iorodeo/expresso_device_hardware/README.txt

Hardware design files (i.e., PCB, enclosure, and mounting rack) for IO 
Rodeo's Expresso device.  An Nx5-channel level detector used for 
measuring the amount of fluid contained in a 1mm diameter capillary tube.
