iorodeo/expresso_device_hardware/fly_holder/svg/top.pdf

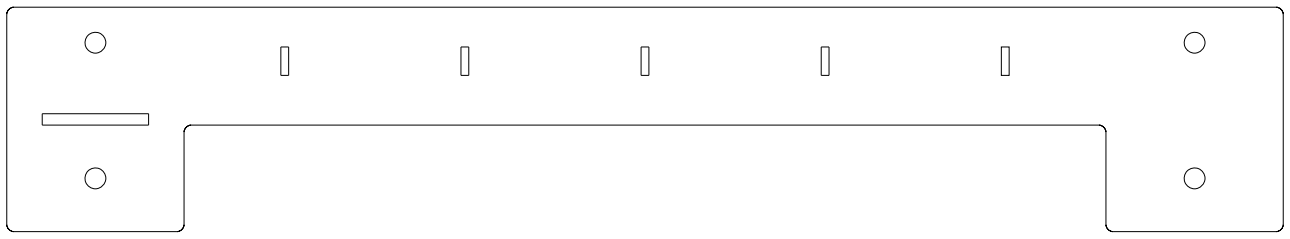
[picture p1: figure]
