iorodeo/expresso_device_hardware/fly_holder/svg/base.pdf

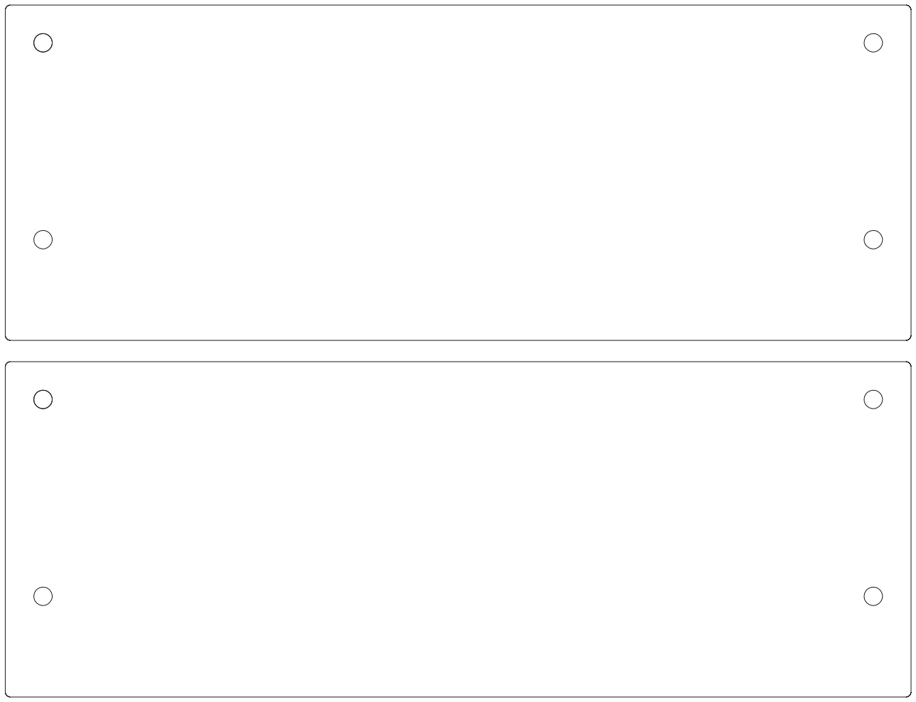
[picture p2: figure]
