iorodeo/expresso_device_hardware/enclosure/pdf/v1.2/1.5mm_white_facr.pdf

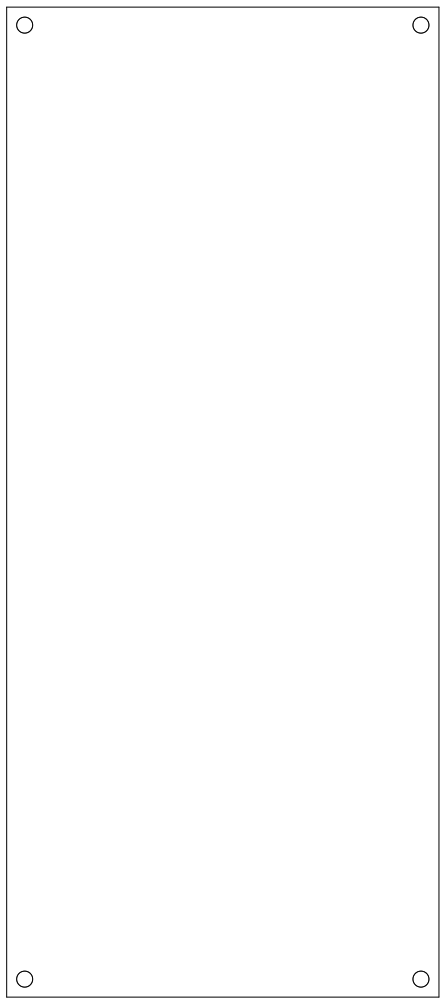
[picture p3: figure]
