iorodeo/expresso_device_hardware/rack/expresso_rack_BOM.txt

Capillary Array Rack - Bill of Materials

Stock parts
===========

Description                                                                                             Vendor          Part#       Price      Qty     Purchased
------------------------------------------------------------------------------------------------------------------------------------------------------------------
* 1/4-20 x 5/16 button socket cap 18-8 stainless steel 50-pack                                          McMaster-Carr   92949A533   7.87       1       no

* 4 hole inside corner bracket                                                                          McMaster-Carr   47065T223   3.98       4       no

* 4-40 threaded insert 10-pack                                                                          McMaster-Carr   99362A200   7.49       1       no

* 4-40 x 3/8 plastic-head thumb screw (black) 25-pack                                                   McMaster-Carr   91185A220   8.65       1       no

* cables-to-go 7 Port USB 2.0 Hub                                                                       Amazon          B000IZDN60  26.68      1       no

Custom parts
============

Description                                                                                             Vendor                                   Qty
----------------------------------------------------------------------------------------------------------------------------------------------------------------------
* capillary rack walls, custom laser cut acrylic part, design files in subdirectory                     IO Rodeo Inc.                             2

* capillary rack foot, custom laser cut acrylic part, design files in subdirectory                      IO Rodeo Inc.                             1

* capillary rack vial shelf, custom laser cut acrylic part, design files in subdirectory                IO Rodeo Inc.                             1

* capillary rack vial cart (floor), custom laser cut acrylic part, design files in subdirectory         IO Rodeo Inc.                             5

* capillary rack vial cart (floor), custom laser cut acrylic part, design files in subdirectory         IO Rodeo Inc.                             5

* capillary rack vial cart (back wall), custom laser cut acrylic part, design files in subdirectory     IO Rodeo Inc.                             5

* capillary rack vial cart (front wall), custom laser cut acrylic part, design files in subdirectory    IO Rodeo Inc.                             5
----------------------------------------------------------------------------------------------------
Desc.                               Qty.    Part No.                    Company             Price($)
----------------------------------------------------------------------------------------------------
1/8" Matte Black Acrylic 8"x12"     1       25094-01                    Inventables         8.00
1/16" Brushed Alum. on Black 4"x12" 1       25257-03                    Incentables         4.36
1/16" Black Acrylic 12"x12"         1       24112-07                    Inventables         4.03
1/16" White (.31T) Acrylic 4"x12"   1       24129-04                    Inventables         1.99
1/16" Clear Acrylic 6"x4"           1       8560K178                    McMaster-Carr       0.84
Aluminum Fem. Hex Standoffs 3/4"    4       91780A113                   McMaster-Carr       2.84
Aluminum M/F. Hex Standoffs 3/16"   4       93505A513                   McMaster-Carr       2.68
3/16" 2-56 Black Ox. Screws         44*     91249A046                   McMaster-Carr       2.14
1/4" 2-56 Black Ox. Screws          4       91249A050                   McMaster-Carr       0.15
1/8" x 1/4" Compressible Spring     5       LW025020125S                Lee Spring          12.0
3/16" 4-40 Black Ox. Sock. Screws   10      91251A105                   McMaster-Carr       0.96

NOTES:
*20 guides, 8 standoffs, 10 sensor PCB, 4 diffuser, 2 LED PCB
