iorodeo/expresso_device_hardware/pcb/led/expresso_led_BOM.txt

----------------------------------------------------------------------------------------------------
Desc.                               Qty.    Part No.                    Company             Price($)
----------------------------------------------------------------------------------------------------
LED RED CLEAR 0805 SMD              75      160-1176-1-ND               Digi-Key            15.74                                                           
RES 120 OHM .2W 5% 0603 SMD         5       660-SG73P1JTTD121J          Mouser              0.70
CONN TERM BLOCK 2 POS WTB           1       478-6169-1-ND               Digi-Key            1.10
JUMPER WIRE - 0.1", 2-PIN, 12"      .5      PRT-10372                   Sparkfun            0.98
