iorodeo/expresso_device_hardware/pcb/accessories_BOM.txt

----------------------------------------------------------------------------------------------------
Desc.                               Qty.    Part No.                    Company             Price($)
----------------------------------------------------------------------------------------------------
TRANS WALL 12VDC 1.0A               1       T1061-P5P-ND                Digi-Key            13.30
RiteAV USB A to Mini-B 1 ft.        1       B001S0I1Z2                  Amazon              4.49
