iorodeo/expresso_device_hardware/fly_holder/assembly/assembly.fcstd

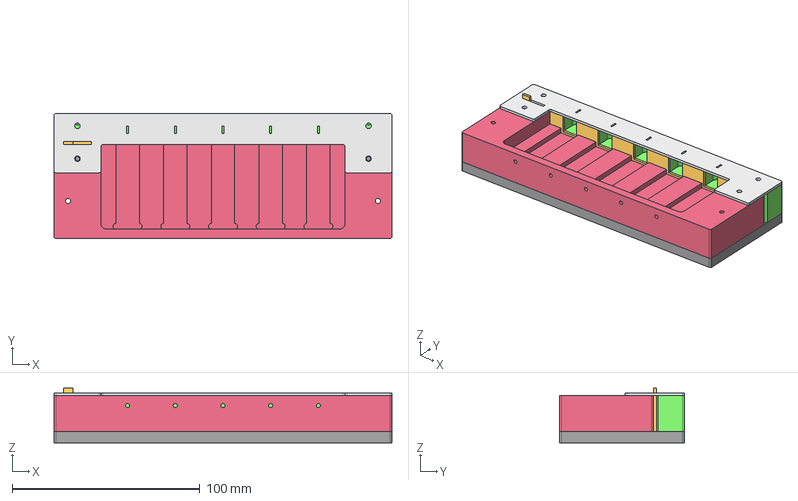
[picture p4: CAD file, 2013-05-25]
fly_holder/assembly/assembly.fcstd
180.0 x 66.6 x 29.1 mm
base
cuvette_block
feeder_block
door
top
