iorodeo/expresso_device_hardware/fly_holder/assembly/assembly_exploded.fcstd

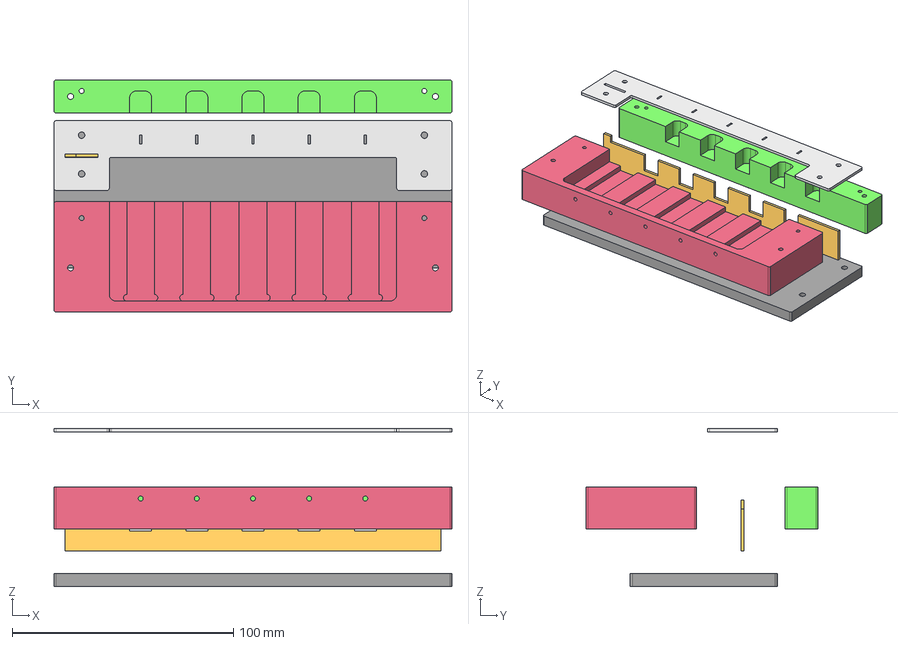
[picture p5: CAD file, 2013-05-25]
fly_holder/assembly/assembly_exploded.fcstd
180.0 x 105.0 x 71.5 mm
base
cuvette_block
feeder_block
door
top
