iorodeo/expresso_device_hardware/enclosure/dxf/back2.dxf

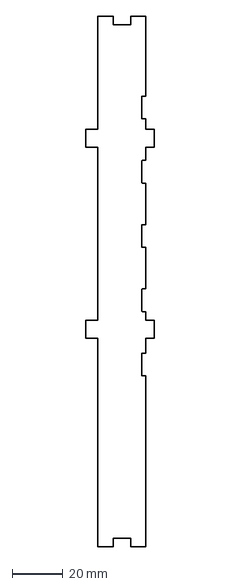
[picture p6: CAD file, 2013-01-23]
enclosure/dxf/back2.dxf
27.2 x 209.9 mm
