iorodeo/expresso_device_hardware/fly_holder/step/feeder_block.step

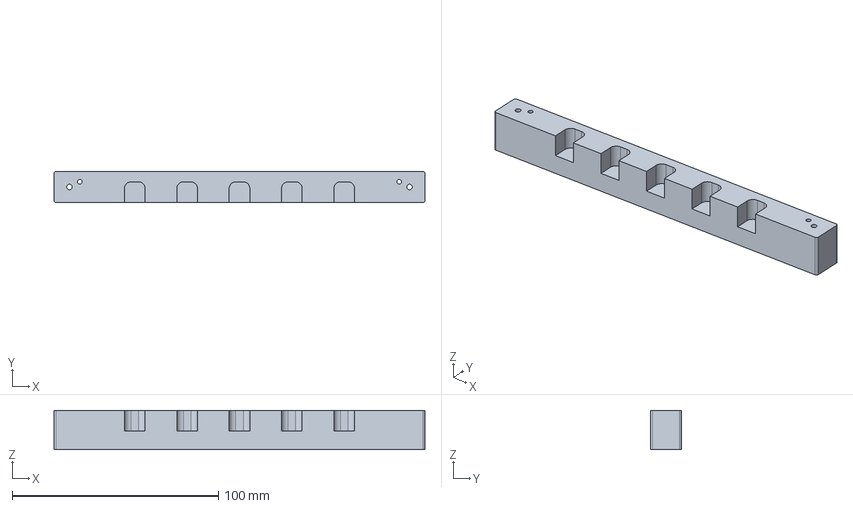
[picture p7: CAD file, 2013-05-25]
fly_holder/step/feeder_block.step
180.0 x 15.0 x 19.0 mm
