iorodeo/expresso_device_hardware/fly_holder/top.fcstd

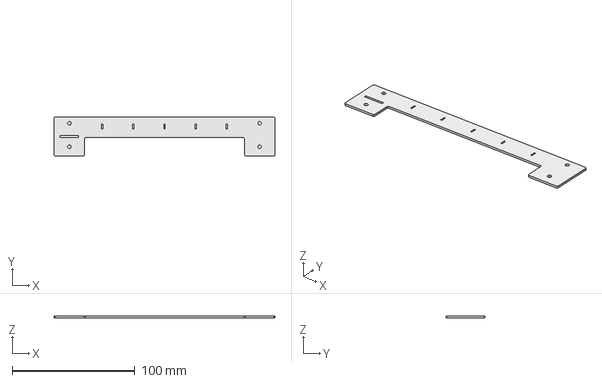
[picture p8: CAD file, 2013-06-08]
fly_holder/top.fcstd
180.0 x 31.6 x 1.50 mm
