iorodeo/expresso_device_hardware/rack/dxf/left_holder.dxf

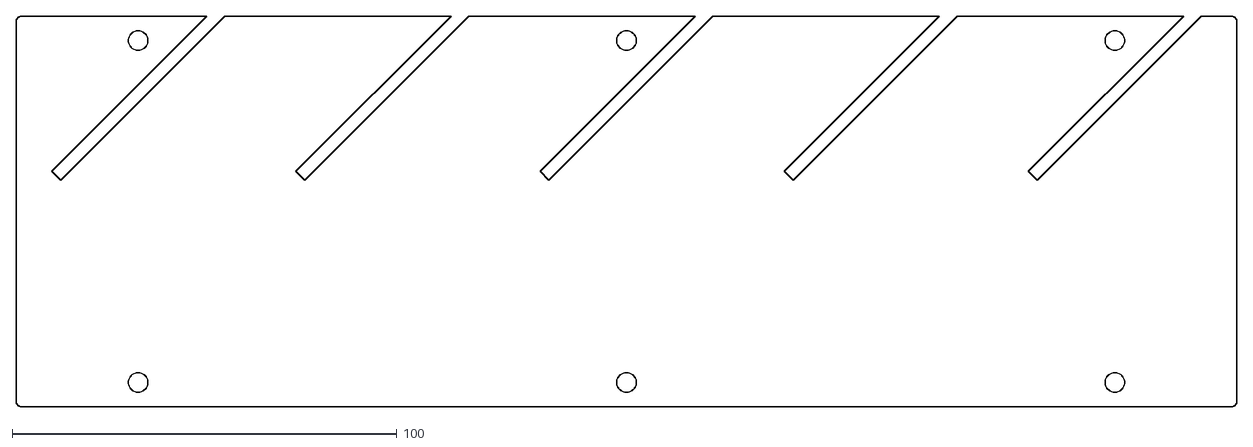
[picture p9: CAD file, 2013-03-14]
rack/dxf/left_holder.dxf
317.5 x 101.6
