iorodeo/expresso_device_hardware/enclosure/dxf/front2.dxf

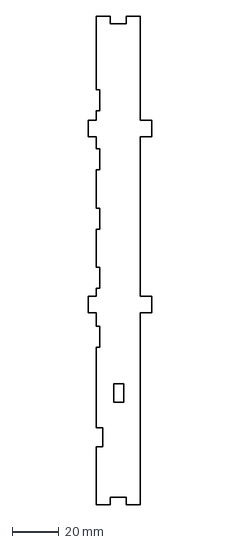
[picture p10: CAD file, 2013-01-23]
enclosure/dxf/front2.dxf
27.2 x 209.9 mm
