iorodeo/expresso_device_hardware/fly_holder/assembly/door.step

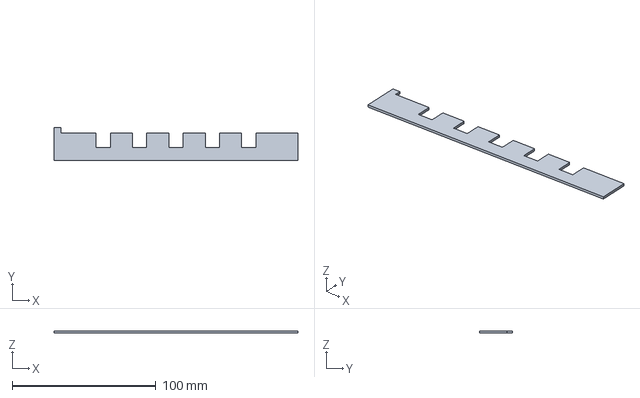
[picture p11: CAD file, 2013-05-25]
fly_holder/assembly/door.step
170.0 x 23.1 x 1.50 mm
