iorodeo/expresso_device_hardware/fly_holder/base.fcstd

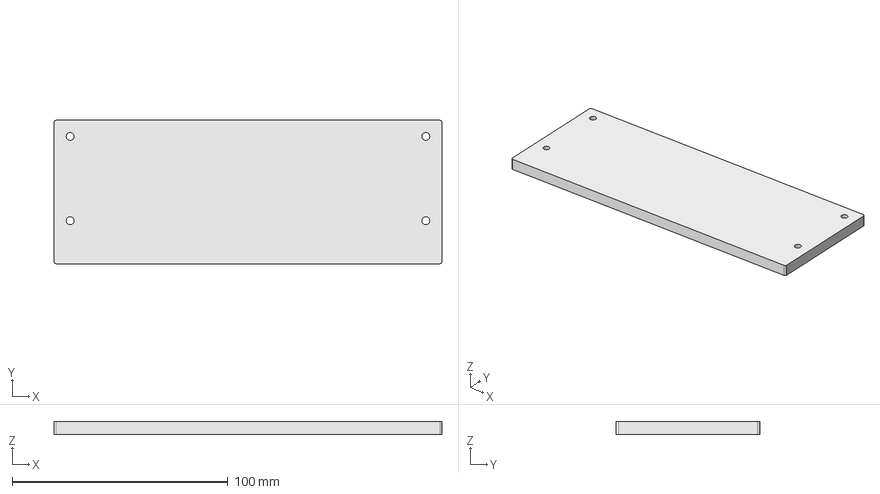
[picture p12: CAD file, 2013-05-25]
fly_holder/base.fcstd
180.0 x 66.6 x 6.00 mm
