iorodeo/expresso_device_hardware/fly_holder/step/cuvette_block.step

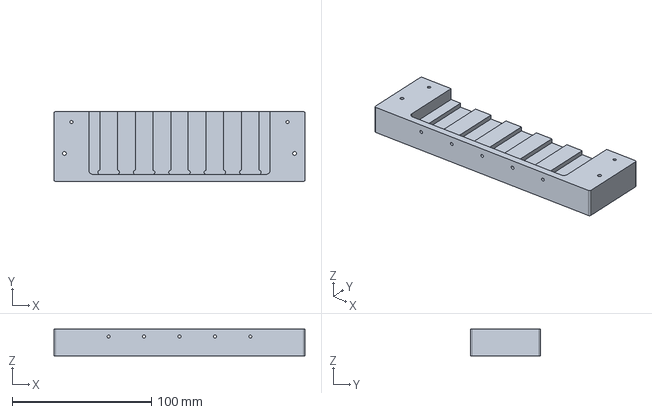
[picture p13: CAD file, 2013-05-25]
fly_holder/step/cuvette_block.step
180.0 x 50.0 x 19.0 mm
