iorodeo/expresso_device_hardware/rack/dxf/floor.dxf

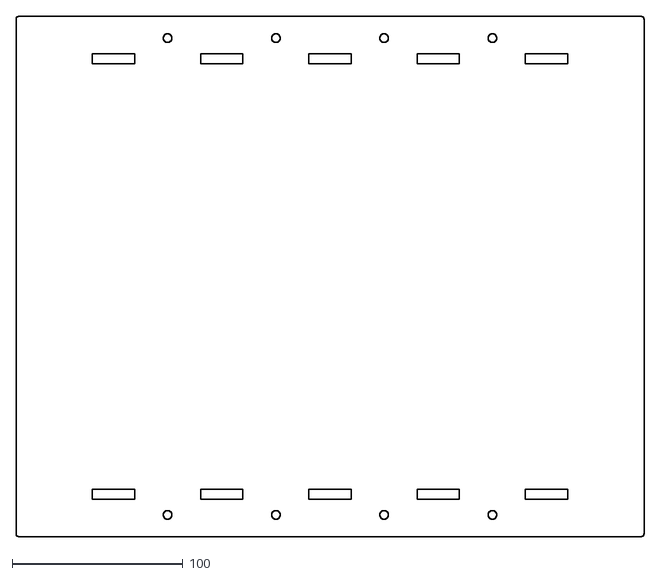
[picture p14: CAD file, 2013-03-14]
rack/dxf/floor.dxf
368.3 x 305.0
