iorodeo/expresso_device_hardware/rack/dxf/left_wall.dxf

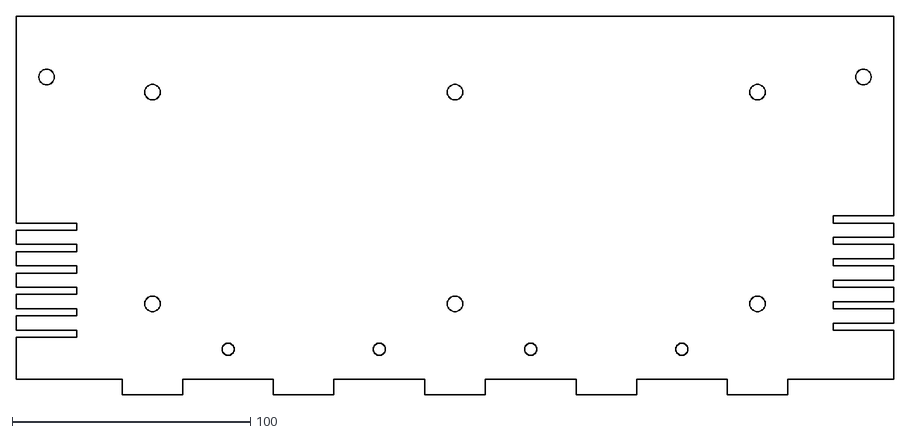
[picture p15: CAD file, 2013-03-14]
rack/dxf/left_wall.dxf
368.3 x 158.7
