iorodeo/expresso_device_hardware/enclosure/dxf/bottom.dxf

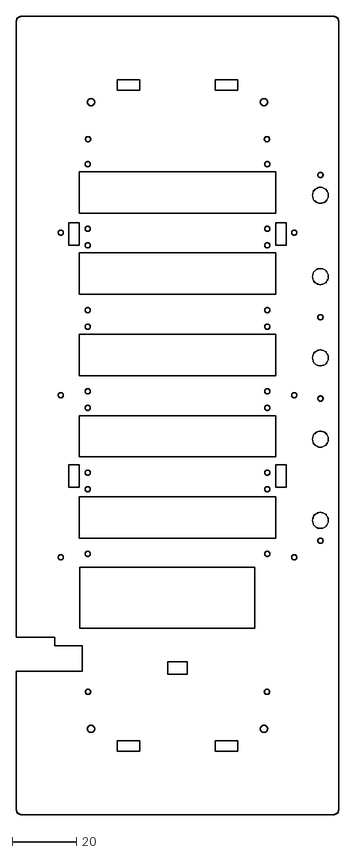
[picture p16: CAD file, 2013-01-22]
enclosure/dxf/bottom.dxf
100.7 x 249.4
