iorodeo/expresso_device_hardware/enclosure/dxf/guide_side_neg_A.dxf

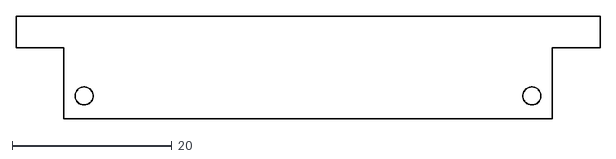
[picture p17: CAD file, 2013-01-22]
enclosure/dxf/guide_side_neg_A.dxf
73.2 x 12.9
