iorodeo/expresso_device_hardware/enclosure/dxf/top.dxf

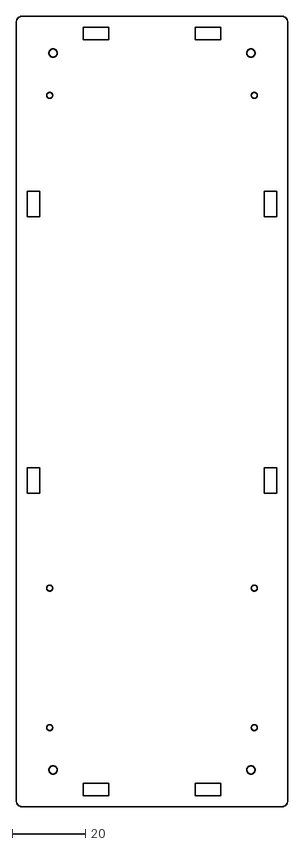
[picture p18: CAD file, 2013-01-22]
enclosure/dxf/top.dxf
74.1 x 215.9
