iorodeo/expresso_device_hardware/fly_holder/assembly/cuvette_block.step

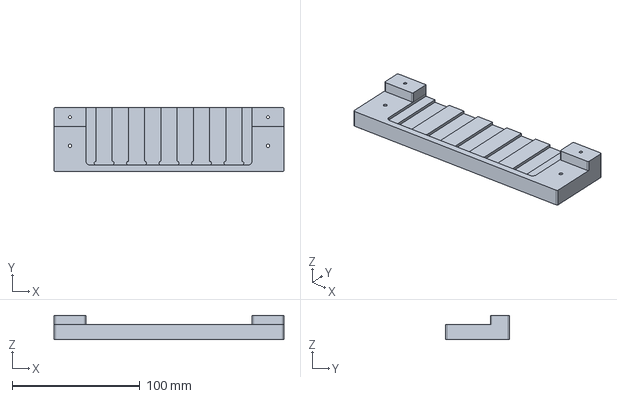
[picture p19: CAD file, 2013-05-09]
fly_holder/assembly/cuvette_block.step
180.0 x 50.0 x 19.0 mm
