iorodeo/expresso_device_hardware/rack/dxf/shelf_bar.dxf

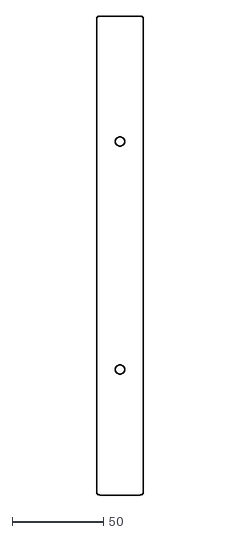
[picture p20: CAD file, 2013-03-14]
rack/dxf/shelf_bar.dxf
25.4 x 261.8
