iorodeo/expresso_device_hardware/enclosure/dxf/back.dxf

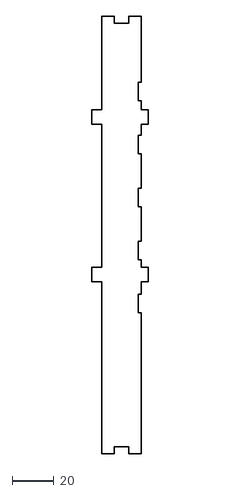
[picture p21: CAD file, 2013-01-22]
enclosure/dxf/back.dxf
27.2 x 209.9
