iorodeo/expresso_device_hardware/fly_holder/assembly/feeder_block.step

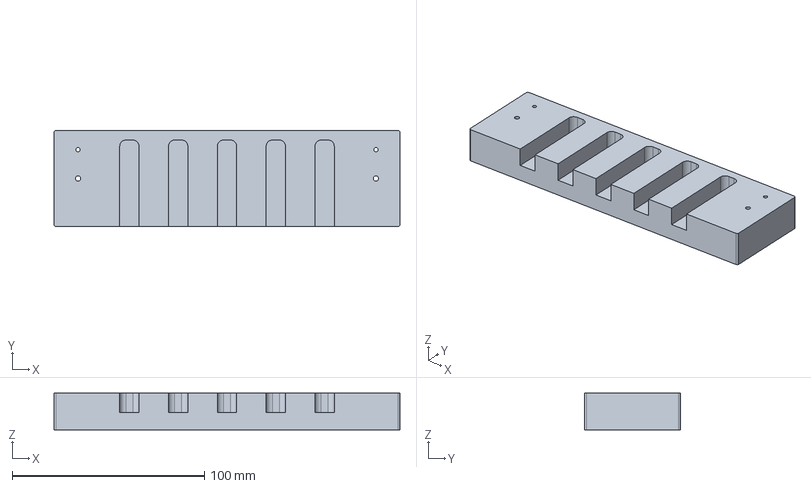
[picture p22: CAD file, 2013-05-09]
fly_holder/assembly/feeder_block.step
180.0 x 50.0 x 19.0 mm
