iorodeo/expresso_device_hardware/rack/dxf/shelf.dxf

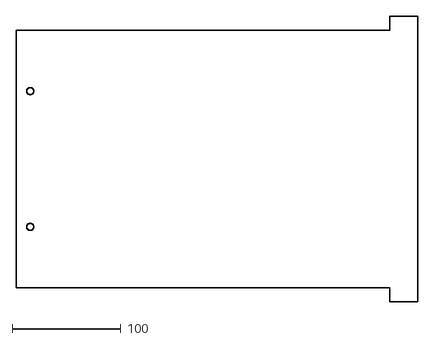
[picture p23: CAD file, 2013-03-14]
rack/dxf/shelf.dxf
368.3 x 261.8
