iorodeo/expresso_device_hardware/enclosure/dxf/guide_side_pos_A.dxf

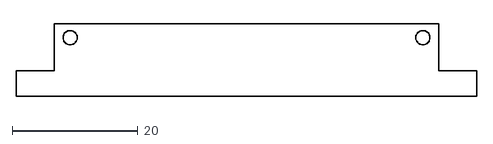
[picture p24: CAD file, 2013-01-22]
enclosure/dxf/guide_side_pos_A.dxf
73.2 x 11.5
