iorodeo/expresso_device_hardware/enclosure/dxf/right_wall2.dxf

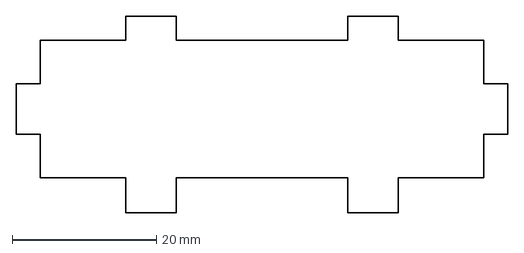
[picture p25: CAD file, 2012-10-20]
enclosure/dxf/right_wall2.dxf
68.1 x 27.2 mm
