iorodeo/expresso_device_hardware/enclosure/dxf/left_wall2.dxf

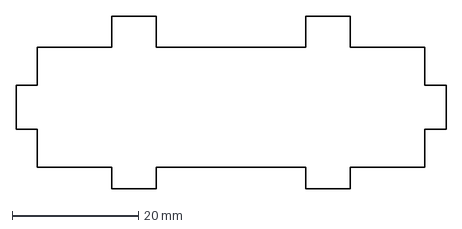
[picture p26: CAD file, 2012-10-20]
enclosure/dxf/left_wall2.dxf
68.1 x 27.2 mm
