iorodeo/expresso_device_hardware/enclosure/dxf/right_wall.dxf

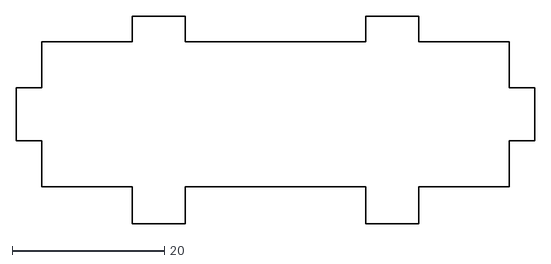
[picture p27: CAD file, 2012-10-19]
enclosure/dxf/right_wall.dxf
68.1 x 27.2
