iorodeo/expresso_device_hardware/enclosure/dxf/left_wall.dxf

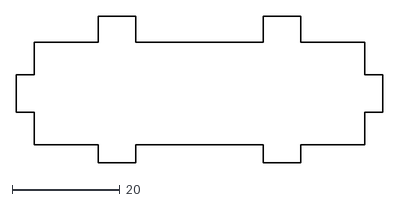
[picture p28: CAD file, 2012-10-19]
enclosure/dxf/left_wall.dxf
68.1 x 27.2
