iorodeo/expresso_device_hardware/enclosure/dxf/ref_cube.dxf

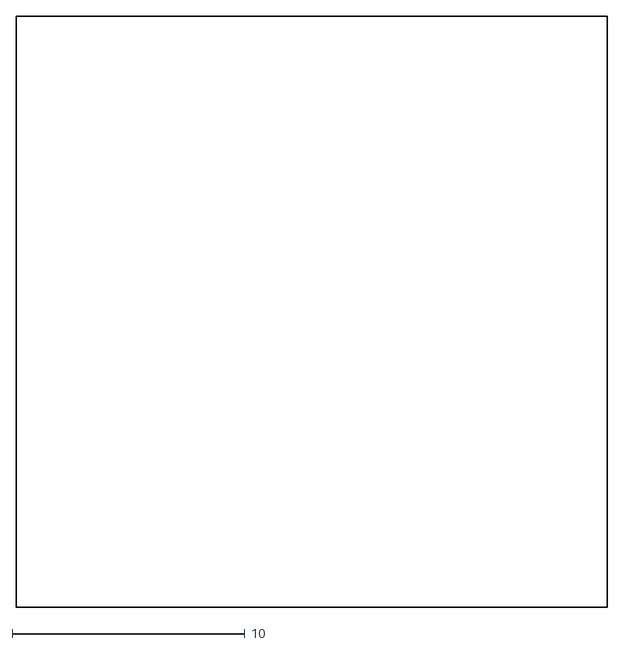
[picture p29: CAD file, 2012-10-18]
enclosure/dxf/ref_cube.dxf
25.4 x 25.4
