iorodeo/expresso_device_hardware/enclosure/dxf/guide_top.dxf

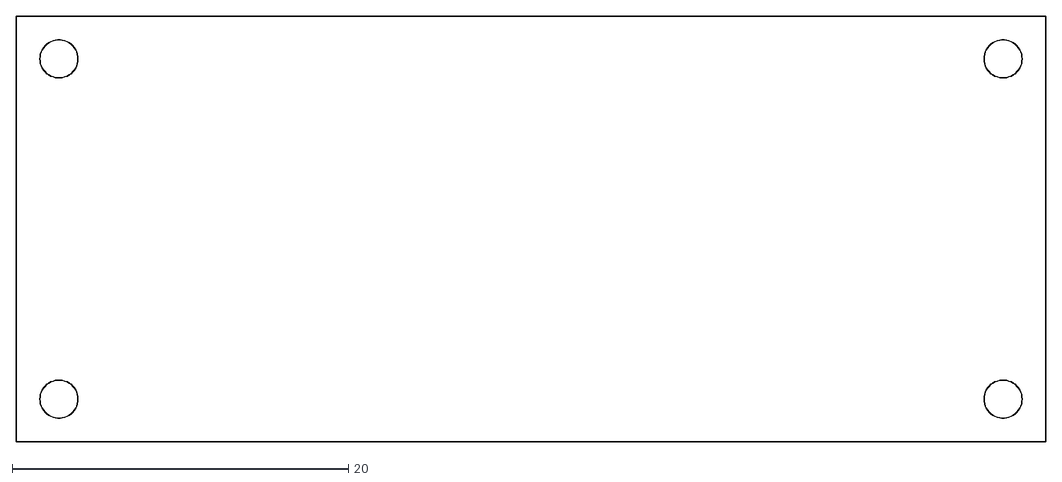
[picture p30: CAD file, 2012-10-18]
enclosure/dxf/guide_top.dxf
61.2 x 25.3
