iorodeo/expresso_device_hardware/enclosure/dxf/plunger_strip.dxf

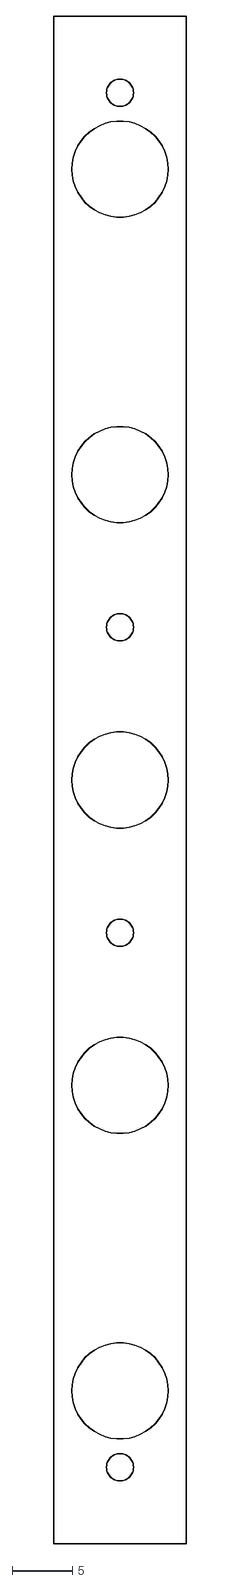
[picture p31: CAD file, 2012-10-18]
enclosure/dxf/plunger_strip.dxf
11.0 x 127.0
