iorodeo/expresso_device_hardware/enclosure/dxf/diffuser.dxf

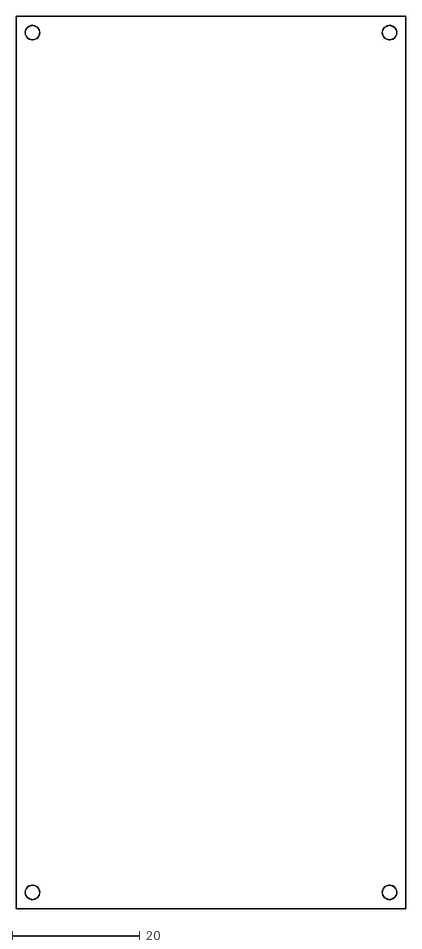
[picture p32: CAD file, 2012-10-18]
enclosure/dxf/diffuser.dxf
61.0 x 139.7
