iorodeo/expresso_device_hardware/enclosure/scad/bottom.scad

//====================================================================//
//========================= scad/bottom.scad =========================//
//                                                                    //
// Autogenerated using py2scad. Hand editing this file is not         //
// advisable as all modifications will be lost when the program which //
// generated this file is re-run.                                     //
//====================================================================//

$fn = 50;
projection(cut=true) {
    difference() {
        difference() {
            difference() {
                difference() {
                    difference() {
                        difference() {
                            difference() {
                                difference() {
                                    difference() {
                                        difference() {
                                            difference() {
                                                difference() {
                                                    difference() {
                                                        difference() {
                                                            difference() {
                                                                difference() {
                                                                    difference() {
                                                                        difference() {
                                                                            difference() {
                                                                                difference() {
                                                                                    difference() {
                                                                                        difference() {
                                                                                            difference() {
                                                                                                difference() {
                                                                                                    difference() {
                                                                                                        difference() {
                                                                                                            difference() {
                                                                                                                difference() {
                                                                                                                    difference() {
                                                                                                                        difference() {
                                                                                                                            difference() {
                                                                                                                                difference() {
                                                                                                                                    difference() {
                                                                                                                                        difference() {
                                                                                                                                            difference() {
                                                                                                                                                difference() {
                                                                                                                                                    difference() {
                                                                                                                                                        difference() {
                                                                                                                                                            difference() {
                                                                                                                                                                difference() {
                                                                                                                                                                    difference() {
                                                                                                                                                                        difference() {
                                                                                                                                                                            difference() {
                                                                                                                                                                                difference() {
                                                                                                                                                                                    difference() {
                                                                                                                                                                                        difference() {
                                                                                                                                                                                            difference() {
                                                                                                                                                                                                difference() {
                                                                                                                                                                                                    difference() {
                                                                                                                                                                                                        difference() {
                                                                                                                                                                                                            difference() {
                                                                                                                                                                                                                difference() {
                                                                                                                                                                                                                    difference() {
                                                                                                                                                                                                                        difference() {
                                                                                                                                                                                                                            difference() {
                                                                                                                                                                                                                                difference() {
                                                                                                                                                                                                                                    difference() {
                                                                                                                                                                                                                                        difference() {
                                                                                                                                                                                                                                            difference() {
                                                                                                                                                                                                                                                difference() {
                                                                                                                                                                                                                                                    difference() {
                                                                                                                                                                                                                                                        difference() {
                                                                                                                                                                                                                                                            difference() {
                                                                                                                                                                                                                                                                difference() {
                                                                                                                                                                                                                                                                    difference() {
                                                                                                                                                                                                                                                                        union() {
                                                                                                                                                                                                                                                                            cube(size=[97.70000, 246.40000, 3.35000], center=true);
                                                                                                                                                                                                                                                                            translate(v=[48.85000, 0.00000, 0.00000]) {
                                                                                                                                                                                                                                                                                cube(size=[3.00000, 246.40000, 3.35000], center=true);
                                                                                                                                                                                                                                                                            }
                                                                                                                                                                                                                                                                            translate(v=[-48.85000, 0.00000, 0.00000]) {
                                                                                                                                                                                                                                                                                cube(size=[3.00000, 246.40000, 3.35000], center=true);
                                                                                                                                                                                                                                                                            }
                                                                                                                                                                                                                                                                            translate(v=[0.00000, 123.20000, 0.00000]) {
                                                                                                                                                                                                                                                                                cube(size=[97.70000, 3.00000, 3.35000], center=true);
                                                                                                                                                                                                                                                                            }
                                                                                                                                                                                                                                                                            translate(v=[0.00000, -123.20000, 0.00000]) {
                                                                                                                                                                                                                                                                                cube(size=[97.70000, 3.00000, 3.35000], center=true);
                                                                                                                                                                                                                                                                            }
                                                                                                                                                                                                                                                                            translate(v=[-48.85000, -123.20000, 0.00000]) {
                                                                                                                                                                                                                                                                                cylinder(h=3.35000,r1=1.50000,r2=1.50000,center=true);
                                                                                                                                                                                                                                                                            }
                                                                                                                                                                                                                                                                            translate(v=[-48.85000, 123.20000, 0.00000]) {
                                                                                                                                                                                                                                                                                cylinder(h=3.35000,r1=1.50000,r2=1.50000,center=true);
                                                                                                                                                                                                                                                                            }
                                                                                                                                                                                                                                                                            translate(v=[48.85000, -123.20000, 0.00000]) {
                                                                                                                                                                                                                                                                                cylinder(h=3.35000,r1=1.50000,r2=1.50000,center=true);
                                                                                                                                                                                                                                                                            }
                                                                                                                                                                                                                                                                            translate(v=[48.85000, 123.20000, 0.00000]) {
                                                                                                                                                                                                                                                                                cylinder(h=3.35000,r1=1.50000,r2=1.50000,center=true);
                                                                                                                                                                                                                                                                            }
                                                                                                                                                                                                                                                                        }
                                                                                                                                                                                                                                                                        translate(v=[-15.35000, -103.27500, 0.00000]) {
                                                                                                                                                                                                                                                                            cube(size=[7.00000, 3.35000, 6.70000], center=true);
                                                                                                                                                                                                                                                                        }
                                                                                                                                                                                                                                                                    }
                                                                                                                                                                                                                                                                    translate(v=[-15.35000, 103.27500, 0.00000]) {
                                                                                                                                                                                                                                                                        cube(size=[7.00000, 3.35000, 6.70000], center=true);
                                                                                                                                                                                                                                                                    }
                                                                                                                                                                                                                                                                }
                                                                                                                                                                                                                                                                translate(v=[15.35000, -103.27500, 0.00000]) {
                                                                                                                                                                                                                                                                    cube(size=[7.00000, 3.35000, 6.70000], center=true);
                                                                                                                                                                                                                                                                }
                                                                                                                                                                                                                                                            }
                                                                                                                                                                                                                                                            translate(v=[15.35000, 103.27500, 0.00000]) {
                                                                                                                                                                                                                                                                cube(size=[7.00000, 3.35000, 6.70000], center=true);
                                                                                                                                                                                                                                                            }
                                                                                                                                                                                                                                                        }
                                                                                                                                                                                                                                                        translate(v=[-32.37500, -18.89100, 0.00000]) {
                                                                                                                                                                                                                                                            cube(size=[3.35000, 7.00000, 6.70000], center=true);
                                                                                                                                                                                                                                                        }
                                                                                                                                                                                                                                                    }
                                                                                                                                                                                                                                                    translate(v=[32.37500, -18.89100, 0.00000]) {
                                                                                                                                                                                                                                                        cube(size=[3.35000, 7.00000, 6.70000], center=true);
                                                                                                                                                                                                                                                    }
                                                                                                                                                                                                                                                }
                                                                                                                                                                                                                                                translate(v=[-32.37500, 56.67300, 0.00000]) {
                                                                                                                                                                                                                                                    cube(size=[3.35000, 7.00000, 6.70000], center=true);
                                                                                                                                                                                                                                                }
                                                                                                                                                                                                                                            }
                                                                                                                                                                                                                                            translate(v=[32.37500, 56.67300, 0.00000]) {
                                                                                                                                                                                                                                                cube(size=[3.35000, 7.00000, 6.70000], center=true);
                                                                                                                                                                                                                                            }
                                                                                                                                                                                                                                        }
                                                                                                                                                                                                                                        translate(v=[-27.02335, -97.92335, 0.00000]) {
                                                                                                                                                                                                                                            cylinder(h=6.70000,r1=1.13030,r2=1.13030,center=true);
                                                                                                                                                                                                                                        }
                                                                                                                                                                                                                                    }
                                                                                                                                                                                                                                    translate(v=[-27.02335, 97.92335, 0.00000]) {
                                                                                                                                                                                                                                        cylinder(h=6.70000,r1=1.13030,r2=1.13030,center=true);
                                                                                                                                                                                                                                    }
                                                                                                                                                                                                                                }
                                                                                                                                                                                                                                translate(v=[27.02335, -97.92335, 0.00000]) {
                                                                                                                                                                                                                                    cylinder(h=6.70000,r1=1.13030,r2=1.13030,center=true);
                                                                                                                                                                                                                                }
                                                                                                                                                                                                                            }
                                                                                                                                                                                                                            translate(v=[27.02335, 97.92335, 0.00000]) {
                                                                                                                                                                                                                                cylinder(h=6.70000,r1=1.13030,r2=1.13030,center=true);
                                                                                                                                                                                                                            }
                                                                                                                                                                                                                        }
                                                                                                                                                                                                                        translate(v=[0.00000, 69.72500, 0.00000]) {
                                                                                                                                                                                                                            cube(size=[61.33000, 12.95000, 6.70000], center=true);
                                                                                                                                                                                                                        }
                                                                                                                                                                                                                    }
                                                                                                                                                                                                                    translate(v=[0.00000, 44.32500, 0.00000]) {
                                                                                                                                                                                                                        cube(size=[61.33000, 12.95000, 6.70000], center=true);
                                                                                                                                                                                                                    }
                                                                                                                                                                                                                }
                                                                                                                                                                                                                translate(v=[0.00000, 18.92500, 0.00000]) {
                                                                                                                                                                                                                    cube(size=[61.33000, 12.95000, 6.70000], center=true);
                                                                                                                                                                                                                }
                                                                                                                                                                                                            }
                                                                                                                                                                                                            translate(v=[0.00000, -6.47500, 0.00000]) {
                                                                                                                                                                                                                cube(size=[61.33000, 12.95000, 6.70000], center=true);
                                                                                                                                                                                                            }
                                                                                                                                                                                                        }
                                                                                                                                                                                                        translate(v=[0.00000, -31.87500, 0.00000]) {
                                                                                                                                                                                                            cube(size=[61.33000, 12.95000, 6.70000], center=true);
                                                                                                                                                                                                        }
                                                                                                                                                                                                    }
                                                                                                                                                                                                    translate(v=[-28.06000, 58.34500, 0.00000]) {
                                                                                                                                                                                                        cylinder(h=6.70000,r1=0.81407,r2=0.81407,center=true);
                                                                                                                                                                                                    }
                                                                                                                                                                                                }
                                                                                                                                                                                                translate(v=[-28.06000, 78.56500, 0.00000]) {
                                                                                                                                                                                                    cylinder(h=6.70000,r1=0.81407,r2=0.81407,center=true);
                                                                                                                                                                                                }
                                                                                                                                                                                            }
                                                                                                                                                                                            translate(v=[28.06000, 58.34500, 0.00000]) {
                                                                                                                                                                                                cylinder(h=6.70000,r1=0.81407,r2=0.81407,center=true);
                                                                                                                                                                                            }
                                                                                                                                                                                        }
                                                                                                                                                                                        translate(v=[28.06000, 78.56500, 0.00000]) {
                                                                                                                                                                                            cylinder(h=6.70000,r1=0.81407,r2=0.81407,center=true);
                                                                                                                                                                                        }
                                                                                                                                                                                    }
                                                                                                                                                                                    translate(v=[-28.06000, 32.94500, 0.00000]) {
                                                                                                                                                                                        cylinder(h=6.70000,r1=0.81407,r2=0.81407,center=true);
                                                                                                                                                                                    }
                                                                                                                                                                                }
                                                                                                                                                                                translate(v=[-28.06000, 53.16500, 0.00000]) {
                                                                                                                                                                                    cylinder(h=6.70000,r1=0.81407,r2=0.81407,center=true);
                                                                                                                                                                                }
                                                                                                                                                                            }
                                                                                                                                                                            translate(v=[28.06000, 32.94500, 0.00000]) {
                                                                                                                                                                                cylinder(h=6.70000,r1=0.81407,r2=0.81407,center=true);
                                                                                                                                                                            }
                                                                                                                                                                        }
                                                                                                                                                                        translate(v=[28.06000, 53.16500, 0.00000]) {
                                                                                                                                                                            cylinder(h=6.70000,r1=0.81407,r2=0.81407,center=true);
                                                                                                                                                                        }
                                                                                                                                                                    }
                                                                                                                                                                    translate(v=[-28.06000, 7.54500, 0.00000]) {
                                                                                                                                                                        cylinder(h=6.70000,r1=0.81407,r2=0.81407,center=true);
                                                                                                                                                                    }
                                                                                                                                                                }
                                                                                                                                                                translate(v=[-28.06000, 27.76500, 0.00000]) {
                                                                                                                                                                    cylinder(h=6.70000,r1=0.81407,r2=0.81407,center=true);
                                                                                                                                                                }
                                                                                                                                                            }
                                                                                                                                                            translate(v=[28.06000, 7.54500, 0.00000]) {
                                                                                                                                                                cylinder(h=6.70000,r1=0.81407,r2=0.81407,center=true);
                                                                                                                                                            }
                                                                                                                                                        }
                                                                                                                                                        translate(v=[28.06000, 27.76500, 0.00000]) {
                                                                                                                                                            cylinder(h=6.70000,r1=0.81407,r2=0.81407,center=true);
                                                                                                                                                        }
                                                                                                                                                    }
                                                                                                                                                    translate(v=[-28.06000, -17.85500, 0.00000]) {
                                                                                                                                                        cylinder(h=6.70000,r1=0.81407,r2=0.81407,center=true);
                                                                                                                                                    }
                                                                                                                                                }
                                                                                                                                                translate(v=[-28.06000, 2.36500, 0.00000]) {
                                                                                                                                                    cylinder(h=6.70000,r1=0.81407,r2=0.81407,center=true);
                                                                                                                                                }
                                                                                                                                            }
                                                                                                                                            translate(v=[28.06000, -17.85500, 0.00000]) {
                                                                                                                                                cylinder(h=6.70000,r1=0.81407,r2=0.81407,center=true);
                                                                                                                                            }
                                                                                                                                        }
                                                                                                                                        translate(v=[28.06000, 2.36500, 0.00000]) {
                                                                                                                                            cylinder(h=6.70000,r1=0.81407,r2=0.81407,center=true);
                                                                                                                                        }
                                                                                                                                    }
                                                                                                                                    translate(v=[-28.06000, -43.25500, 0.00000]) {
                                                                                                                                        cylinder(h=6.70000,r1=0.81407,r2=0.81407,center=true);
                                                                                                                                    }
                                                                                                                                }
                                                                                                                                translate(v=[-28.06000, -23.03500, 0.00000]) {
                                                                                                                                    cylinder(h=6.70000,r1=0.81407,r2=0.81407,center=true);
                                                                                                                                }
                                                                                                                            }
                                                                                                                            translate(v=[28.06000, -43.25500, 0.00000]) {
                                                                                                                                cylinder(h=6.70000,r1=0.81407,r2=0.81407,center=true);
                                                                                                                            }
                                                                                                                        }
                                                                                                                        translate(v=[28.06000, -23.03500, 0.00000]) {
                                                                                                                            cylinder(h=6.70000,r1=0.81407,r2=0.81407,center=true);
                                                                                                                        }
                                                                                                                    }
                                                                                                                    translate(v=[-3.19500, -56.90000, 0.00000]) {
                                                                                                                        cube(size=[54.61000, 19.05000, 6.70000], center=true);
                                                                                                                    }
                                                                                                                }
                                                                                                                translate(v=[-34.40000, -75.90000, 0.00000]) {
                                                                                                                    cube(size=[9.20000, 8.00000, 6.70000], center=true);
                                                                                                                }
                                                                                                            }
                                                                                                            translate(v=[-50.35000, -74.60000, 0.00000]) {
                                                                                                                cube(size=[23.83500, 10.60000, 6.70000], center=true);
                                                                                                            }
                                                                                                        }
                                                                                                        translate(v=[0.00000, -78.90000, 0.00000]) {
                                                                                                            cube(size=[6.00000, 4.00000, 6.70000], center=true);
                                                                                                        }
                                                                                                    }
                                                                                                    translate(v=[-27.96000, 86.36000, 0.00000]) {
                                                                                                        cylinder(h=6.70000,r1=0.81407,r2=0.81407,center=true);
                                                                                                    }
                                                                                                }
                                                                                                translate(v=[27.96000, 86.36000, 0.00000]) {
                                                                                                    cylinder(h=6.70000,r1=0.81407,r2=0.81407,center=true);
                                                                                                }
                                                                                            }
                                                                                            translate(v=[-27.96000, -86.36000, 0.00000]) {
                                                                                                cylinder(h=6.70000,r1=0.81407,r2=0.81407,center=true);
                                                                                            }
                                                                                        }
                                                                                        translate(v=[27.96000, -86.36000, 0.00000]) {
                                                                                            cylinder(h=6.70000,r1=0.81407,r2=0.81407,center=true);
                                                                                        }
                                                                                    }
                                                                                    translate(v=[-36.46000, -44.32500, 0.00000]) {
                                                                                        cylinder(h=6.70000,r1=0.81407,r2=0.81407,center=true);
                                                                                    }
                                                                                }
                                                                                translate(v=[36.46000, -44.32500, 0.00000]) {
                                                                                    cylinder(h=6.70000,r1=0.81407,r2=0.81407,center=true);
                                                                                }
                                                                            }
                                                                            translate(v=[-36.46000, 6.35000, 0.00000]) {
                                                                                cylinder(h=6.70000,r1=0.81407,r2=0.81407,center=true);
                                                                            }
                                                                        }
                                                                        translate(v=[36.46000, 6.35000, 0.00000]) {
                                                                            cylinder(h=6.70000,r1=0.81407,r2=0.81407,center=true);
                                                                        }
                                                                    }
                                                                    translate(v=[-36.46000, 57.15000, 0.00000]) {
                                                                        cylinder(h=6.70000,r1=0.81407,r2=0.81407,center=true);
                                                                    }
                                                                }
                                                                translate(v=[36.46000, 57.15000, 0.00000]) {
                                                                    cylinder(h=6.70000,r1=0.81407,r2=0.81407,center=true);
                                                                }
                                                            }
                                                            translate(v=[44.67500, 68.80500, 0.00000]) {
                                                                cylinder(h=6.70000,r1=2.50000,r2=2.50000,center=true);
                                                            }
                                                        }
                                                        translate(v=[44.67500, 75.15500, 0.00000]) {
                                                            cylinder(h=6.70000,r1=0.81407,r2=0.81407,center=true);
                                                        }
                                                    }
                                                    translate(v=[44.67500, 43.40500, 0.00000]) {
                                                        cylinder(h=6.70000,r1=2.50000,r2=2.50000,center=true);
                                                    }
                                                }
                                                translate(v=[44.67500, 30.70500, 0.00000]) {
                                                    cylinder(h=6.70000,r1=0.81407,r2=0.81407,center=true);
                                                }
                                            }
                                            translate(v=[44.67500, 18.00500, 0.00000]) {
                                                cylinder(h=6.70000,r1=2.50000,r2=2.50000,center=true);
                                            }
                                        }
                                        translate(v=[44.67500, 5.30500, 0.00000]) {
                                            cylinder(h=6.70000,r1=0.81407,r2=0.81407,center=true);
                                        }
                                    }
                                    translate(v=[44.67500, -7.39500, 0.00000]) {
                                        cylinder(h=6.70000,r1=2.50000,r2=2.50000,center=true);
                                    }
                                }
                                translate(v=[44.67500, -32.79500, 0.00000]) {
                                    cylinder(h=6.70000,r1=2.50000,r2=2.50000,center=true);
                                }
                            }
                            translate(v=[44.67500, -39.14500, 0.00000]) {
                                cylinder(h=6.70000,r1=0.81407,r2=0.81407,center=true);
                            }
                        }
                        translate(v=[44.67500, 68.80500, -1.67500]) {
                            cylinder(h=3.00000,r1=4.00000,r2=4.00000,center=true);
                        }
                    }
                    translate(v=[44.67500, 43.40500, -1.67500]) {
                        cylinder(h=3.00000,r1=4.00000,r2=4.00000,center=true);
                    }
                }
                translate(v=[44.67500, 18.00500, -1.67500]) {
                    cylinder(h=3.00000,r1=4.00000,r2=4.00000,center=true);
                }
            }
            translate(v=[44.67500, -7.39500, -1.67500]) {
                cylinder(h=3.00000,r1=4.00000,r2=4.00000,center=true);
            }
        }
        translate(v=[44.67500, -32.79500, -1.67500]) {
            cylinder(h=3.00000,r1=4.00000,r2=4.00000,center=true);
        }
    }
}
