iorodeo/expresso_device_hardware/(list of files, cad)

Other CAD files:
fly_holder/door.fcstd
fly_holder/assembly/top.step
fly_holder/assembly/base.step
enclosure/scad/diffuser.scad
enclosure/scad/enclosure_assembly.scad
enclosure/scad/enclosure_projection.scad
enclosure/scad/expresso_projection.scad
enclosure/scad/front.scad
enclosure/scad/guide_side_pos_A.scad
enclosure/scad/guide_top.scad
enclosure/scad/left_wall.scad
enclosure/scad/ref_cube.scad
enclosure/scad/right_wall.scad
enclosure/scad/top.scad
rack/scad/rack_assembly.scad
rack/scad/right_holder.scad
rack/scad/right_wall.scad
rack/scad/shelf_bar.scad
fly_holder/cuvette_block.fcstd
fly_holder/feeder_block.fcstd
