iorodeo/expresso_device_hardware/rack/pdf/floor.pdf

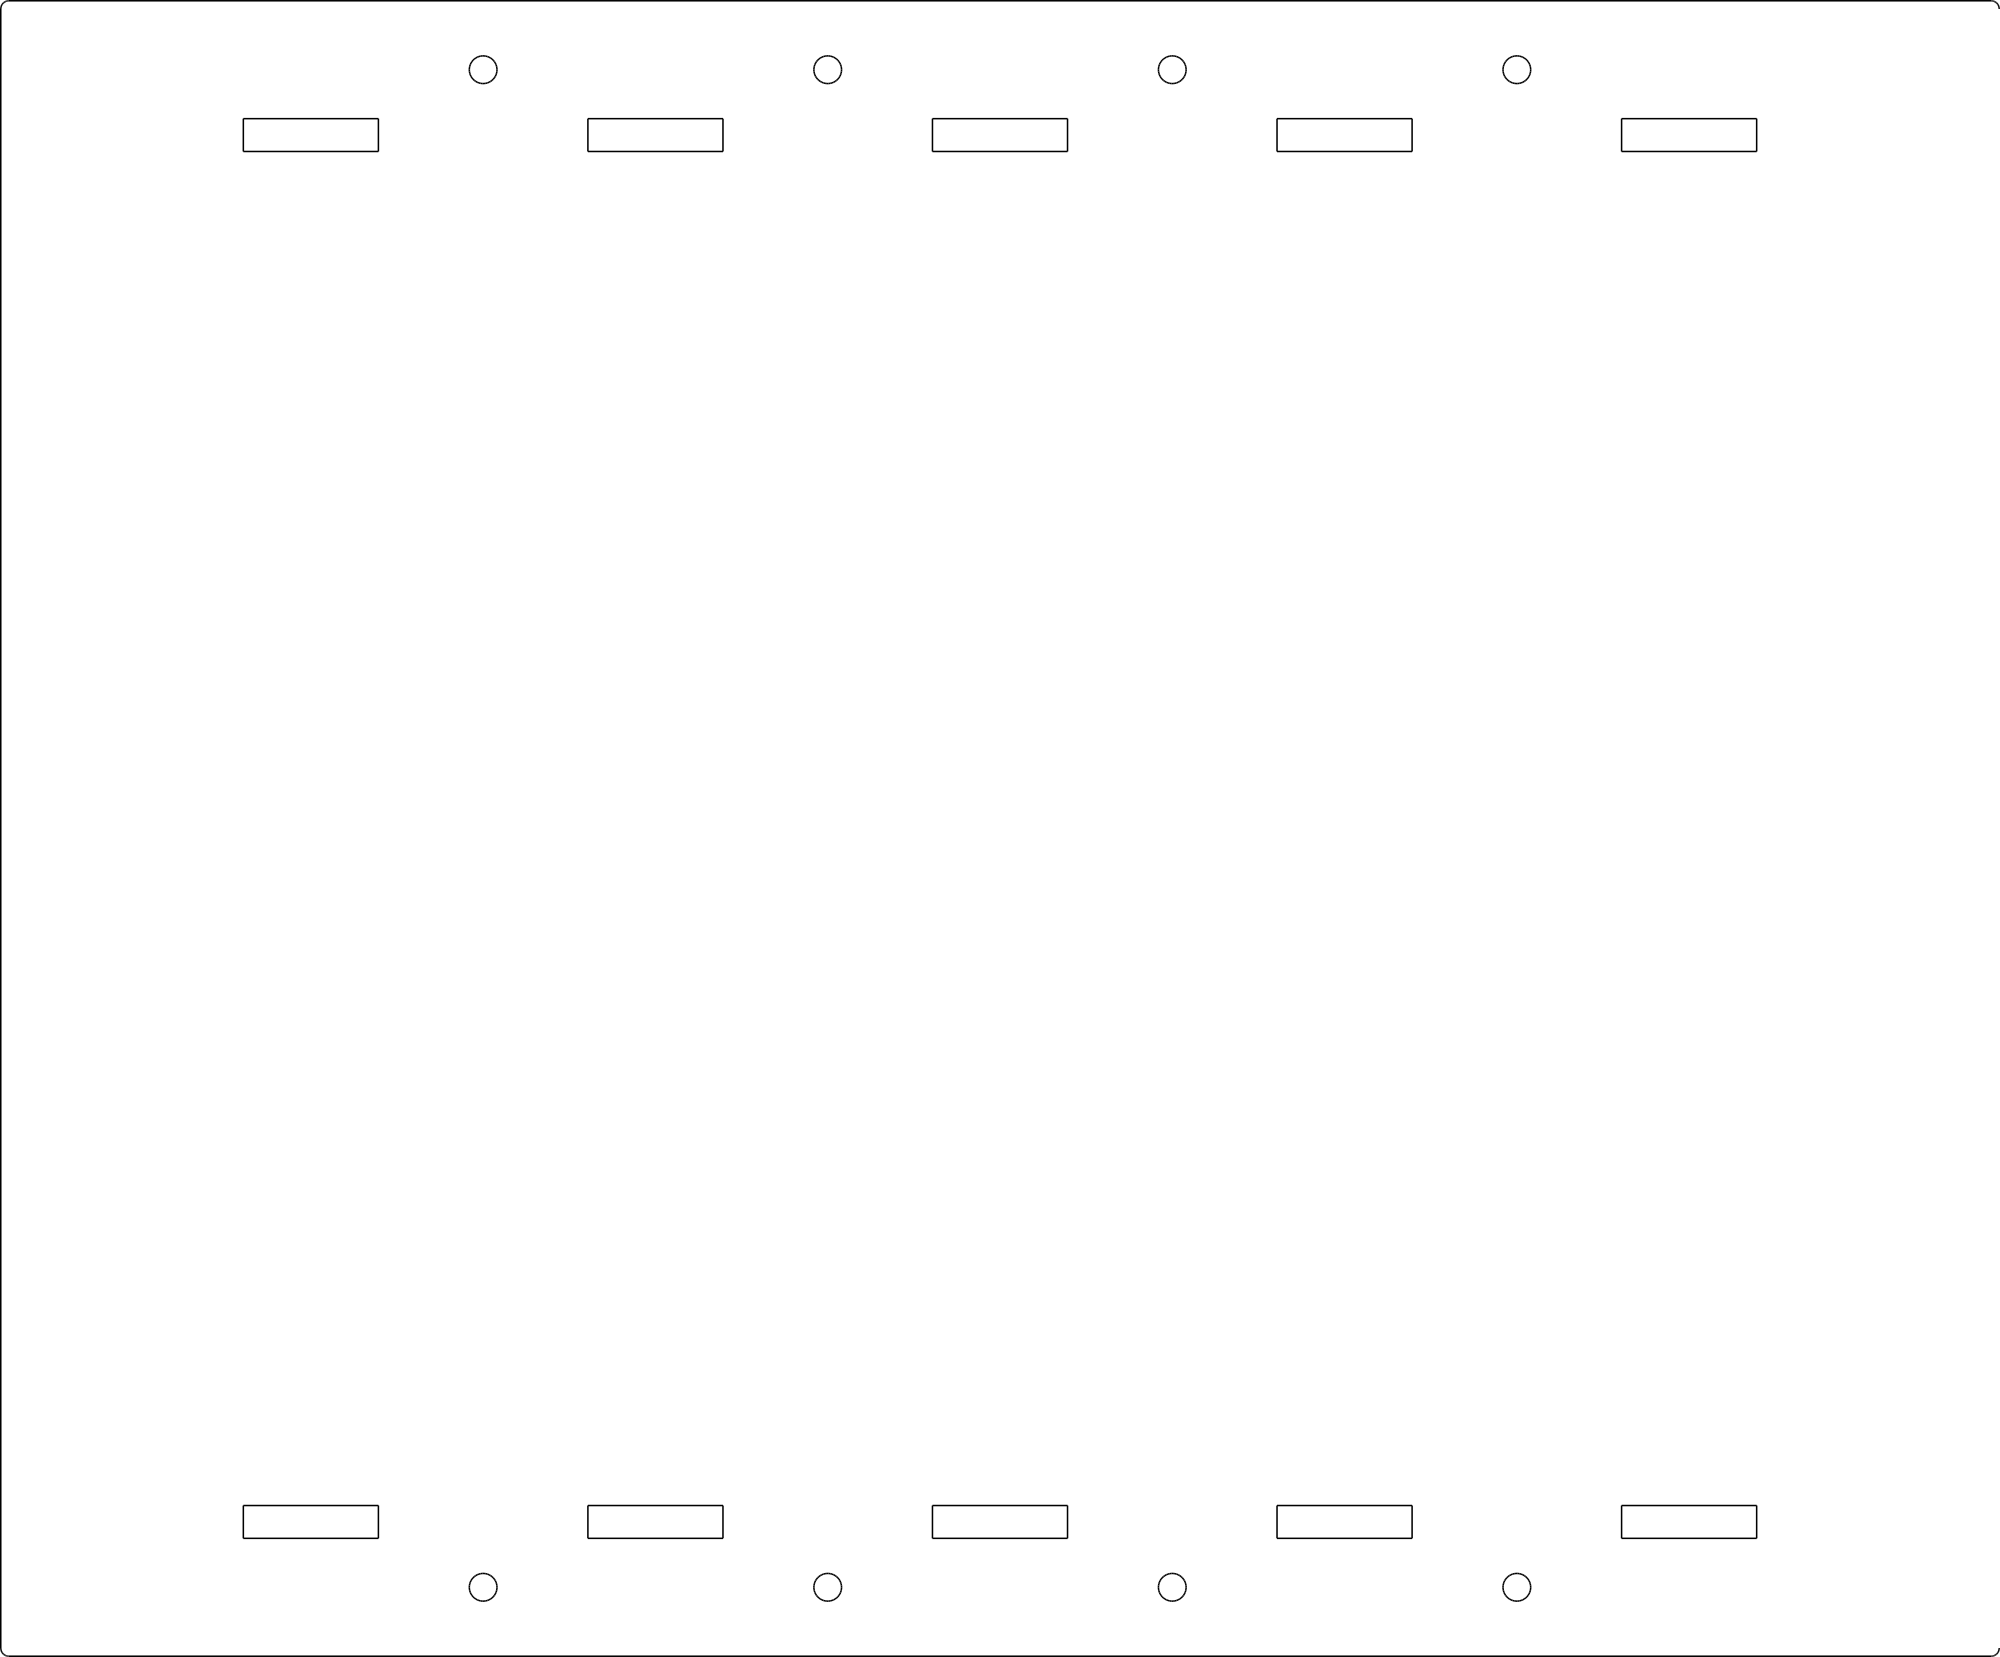
[picture p33: page 1]
