iorodeo/expresso_device_hardware/rack/pdf/shelf.pdf

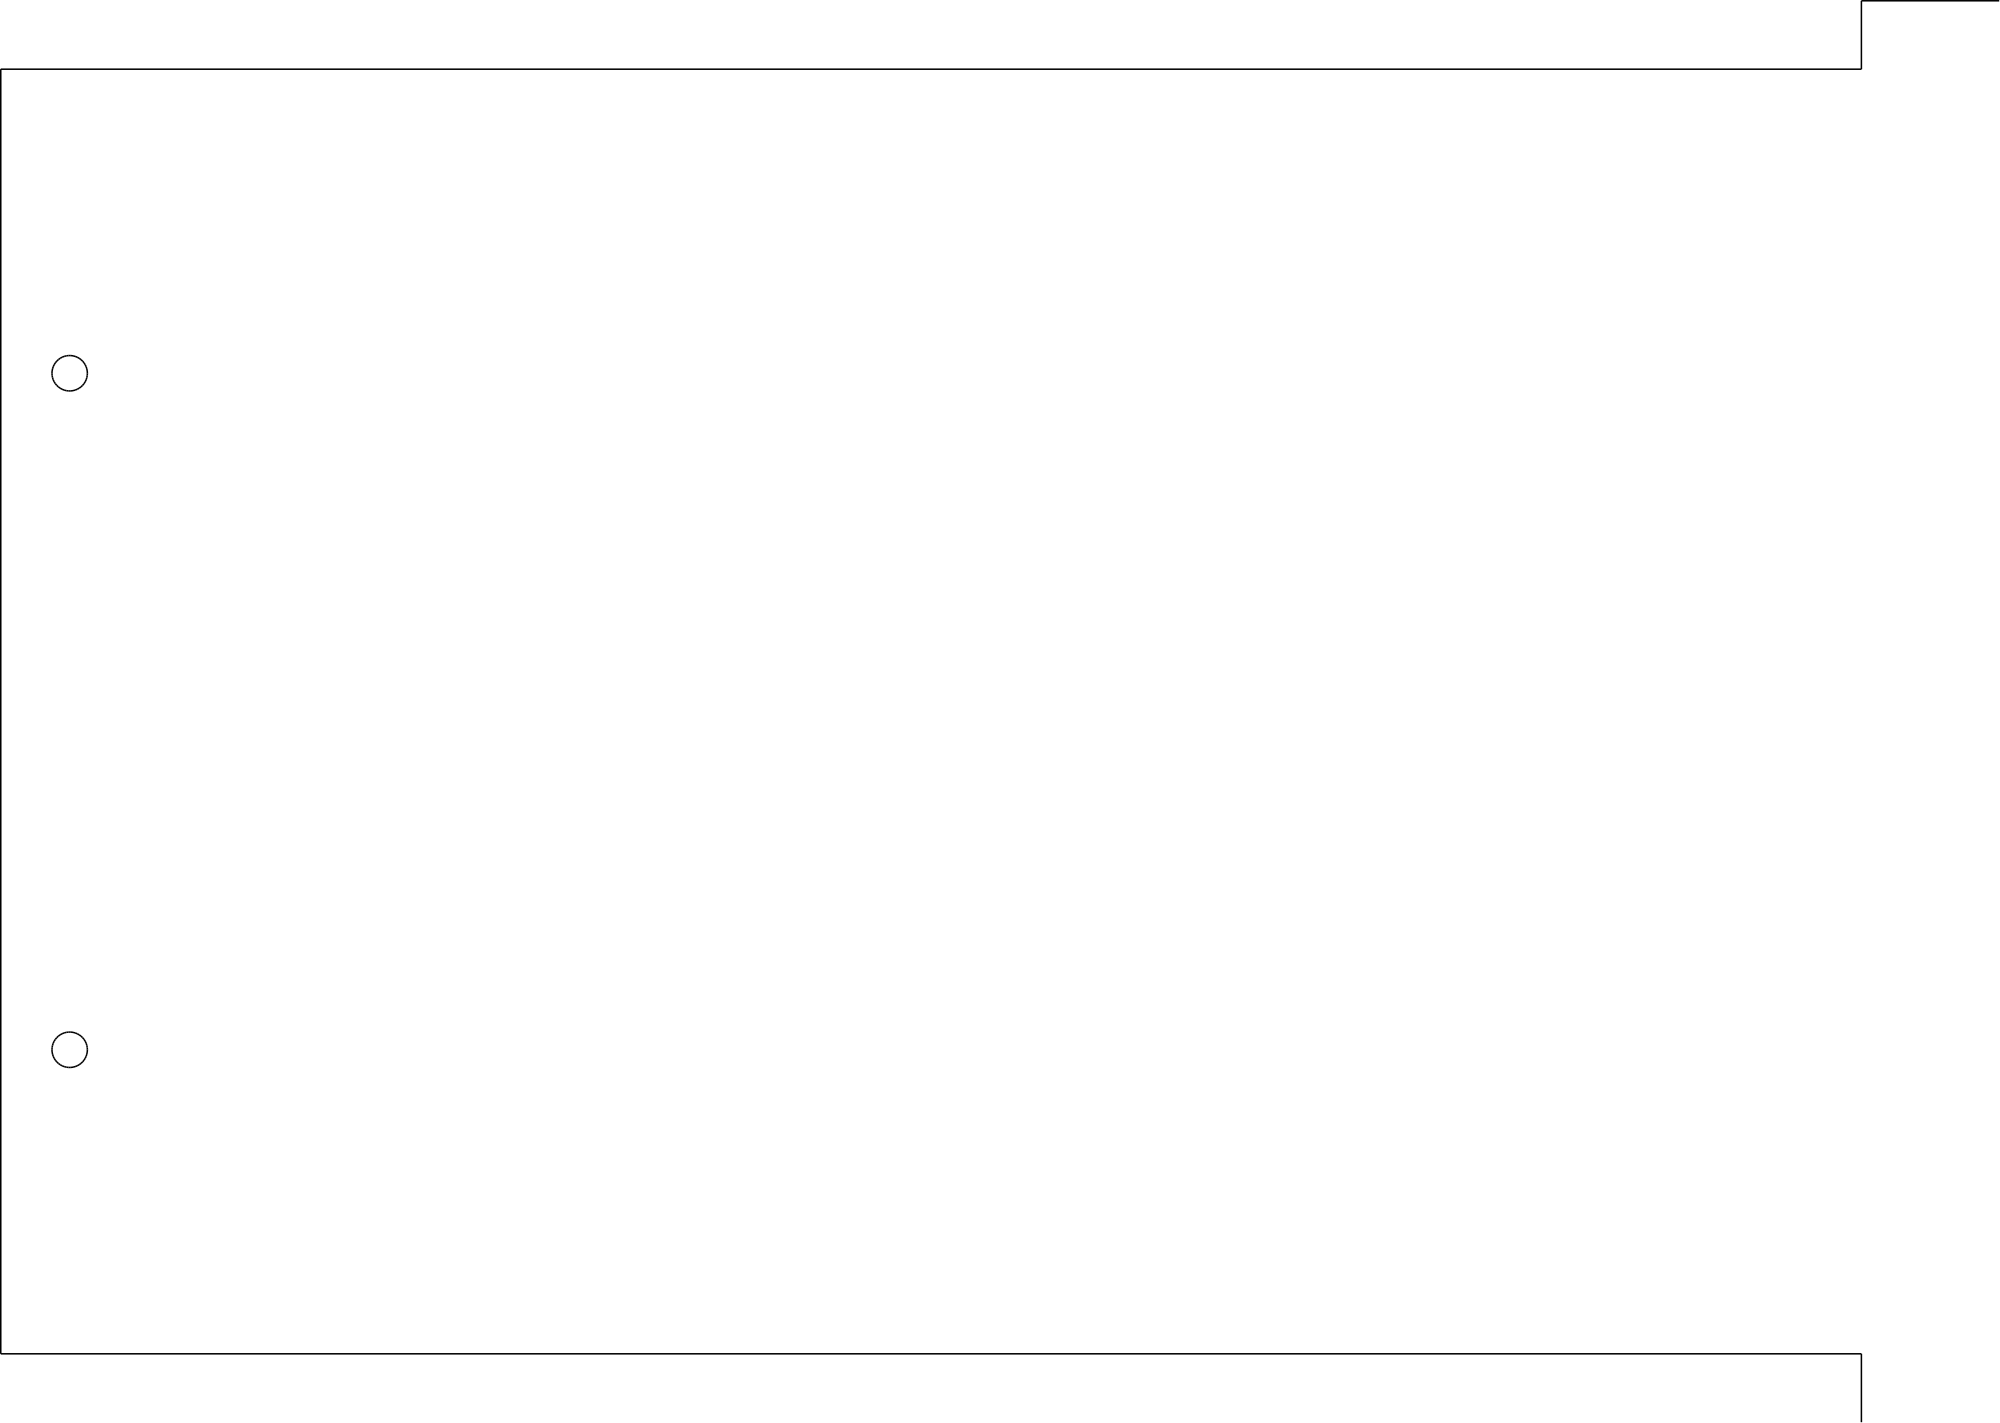
[picture p34: page 1]
