iorodeo/expresso_device_hardware/enclosure/pdf/v1.2/1.5mm_black_acr.pdf

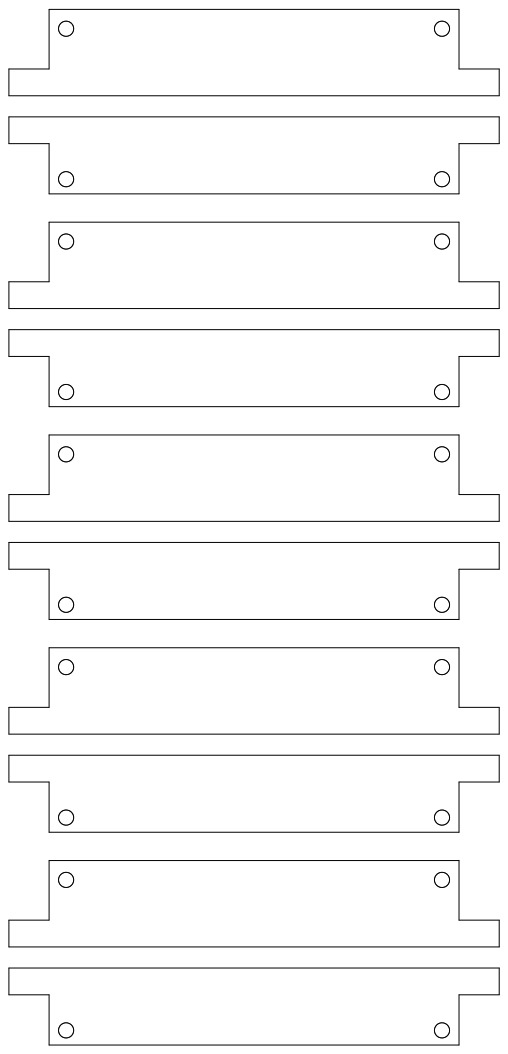
[picture p35: page 1]
