iorodeo/expresso_device_hardware/enclosure/pdf/v1.2/1.5mm_silver_acr.pdf

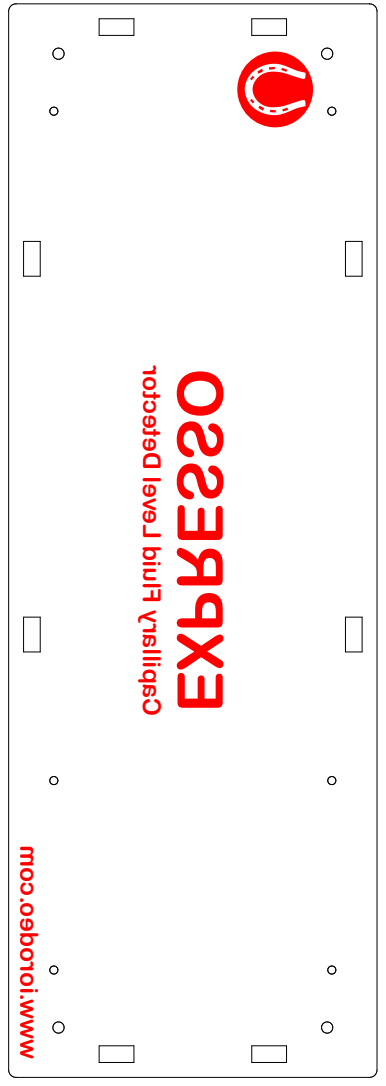
[picture p36: page 1]
EXPRESSO

Capillary Fluid Level Detector

www.iorodeo.com
