iorodeo/expresso_device_hardware/enclosure/pdf/v1.2/3mm_black_macr.pdf

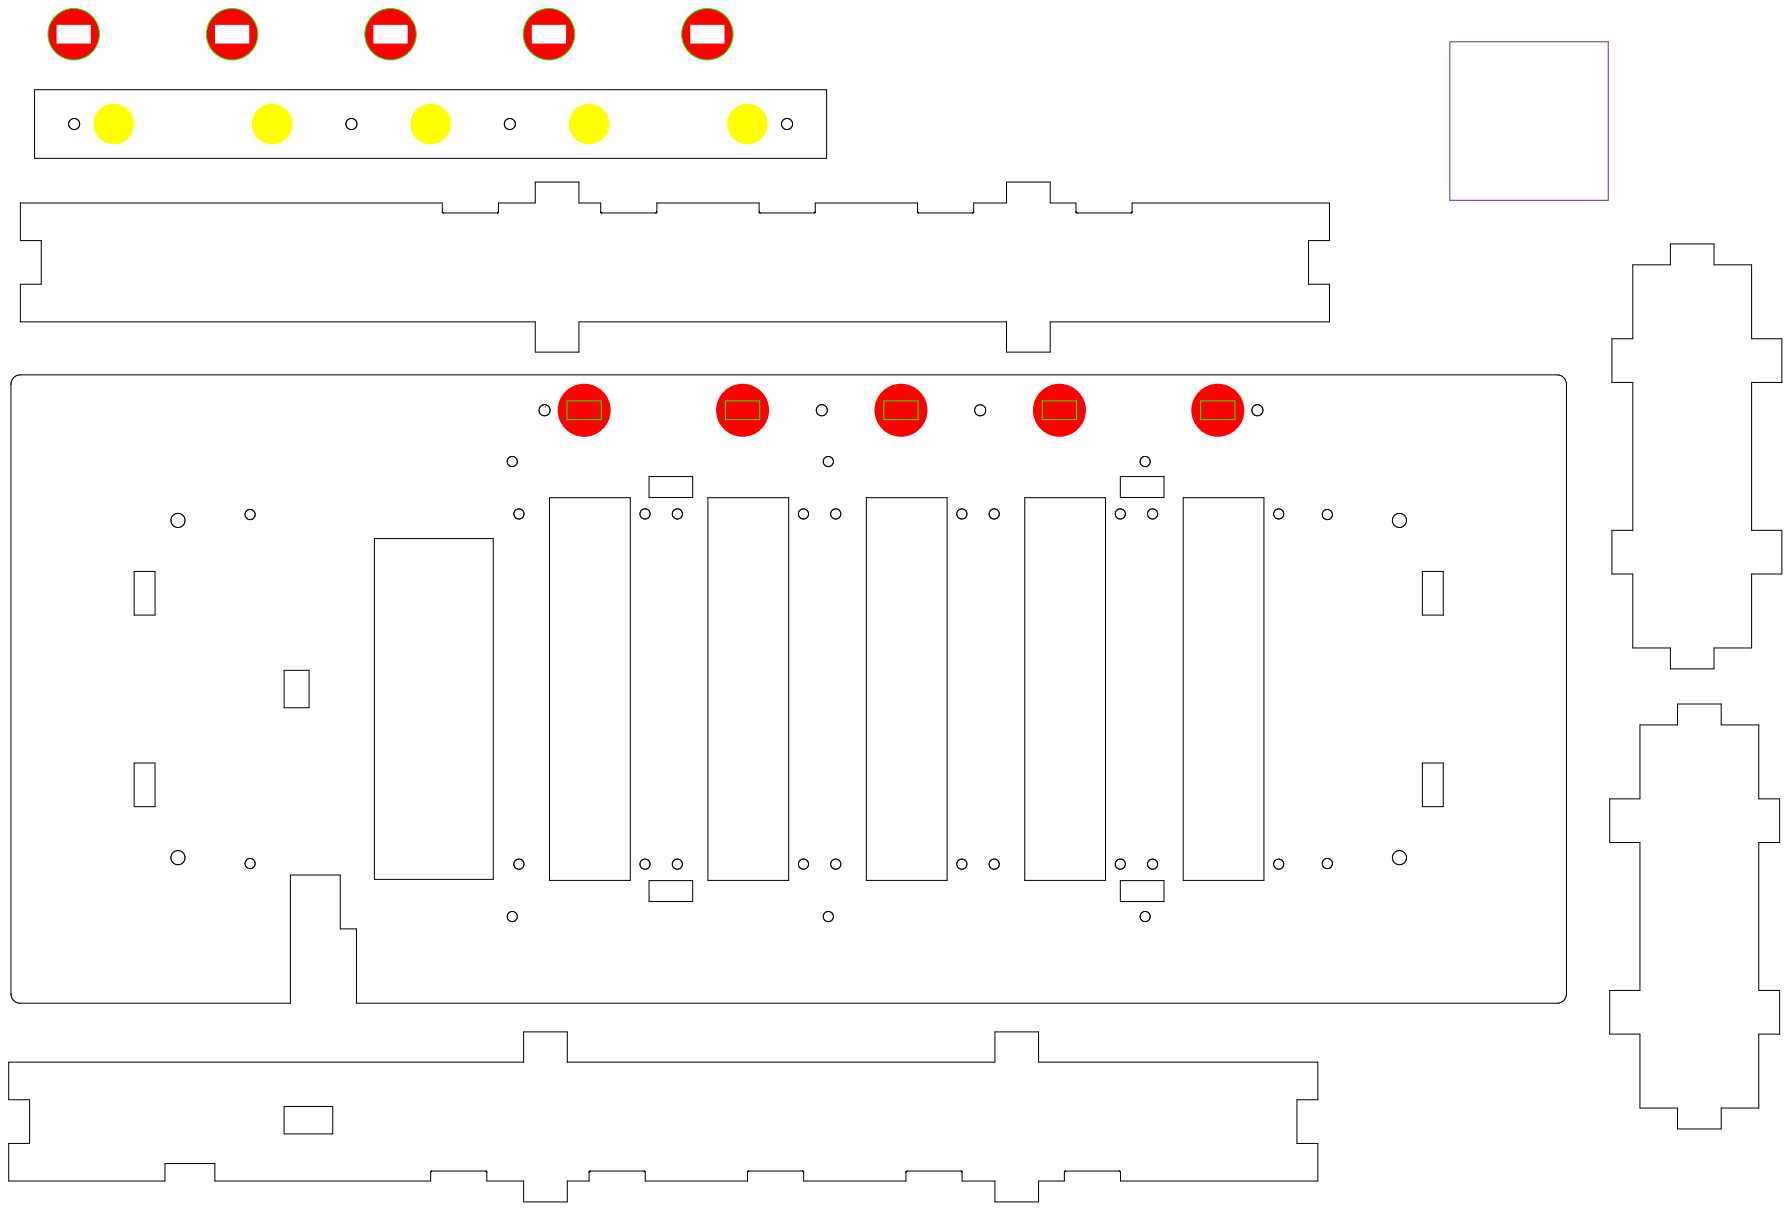
[picture p37: page 1]
