iorodeo/expresso_device_hardware/enclosure/pdf/v1.2/1.5mm_clear_acr.pdf

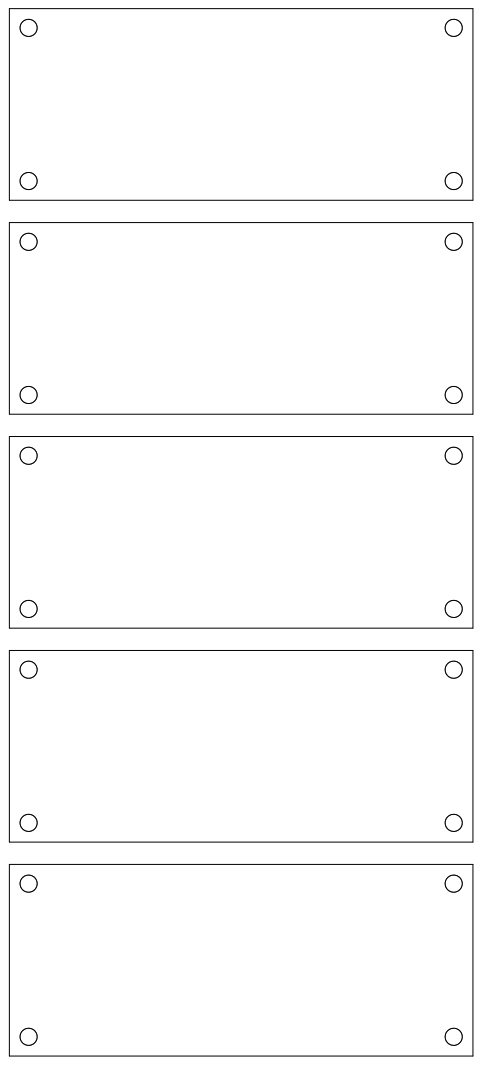
[picture p38: page 1]
