iorodeo/expresso_device_hardware/(list of files, drawings)

Other design files:
pcb/led/expresso_led.dsn
pcb/sensor/expresso_sensor.dsn
