iorodeo/expresso_device_hardware/pcb/led/expresso_led.sch

## KiCad design pcb/led/expresso_led.sch (2012-07-24)

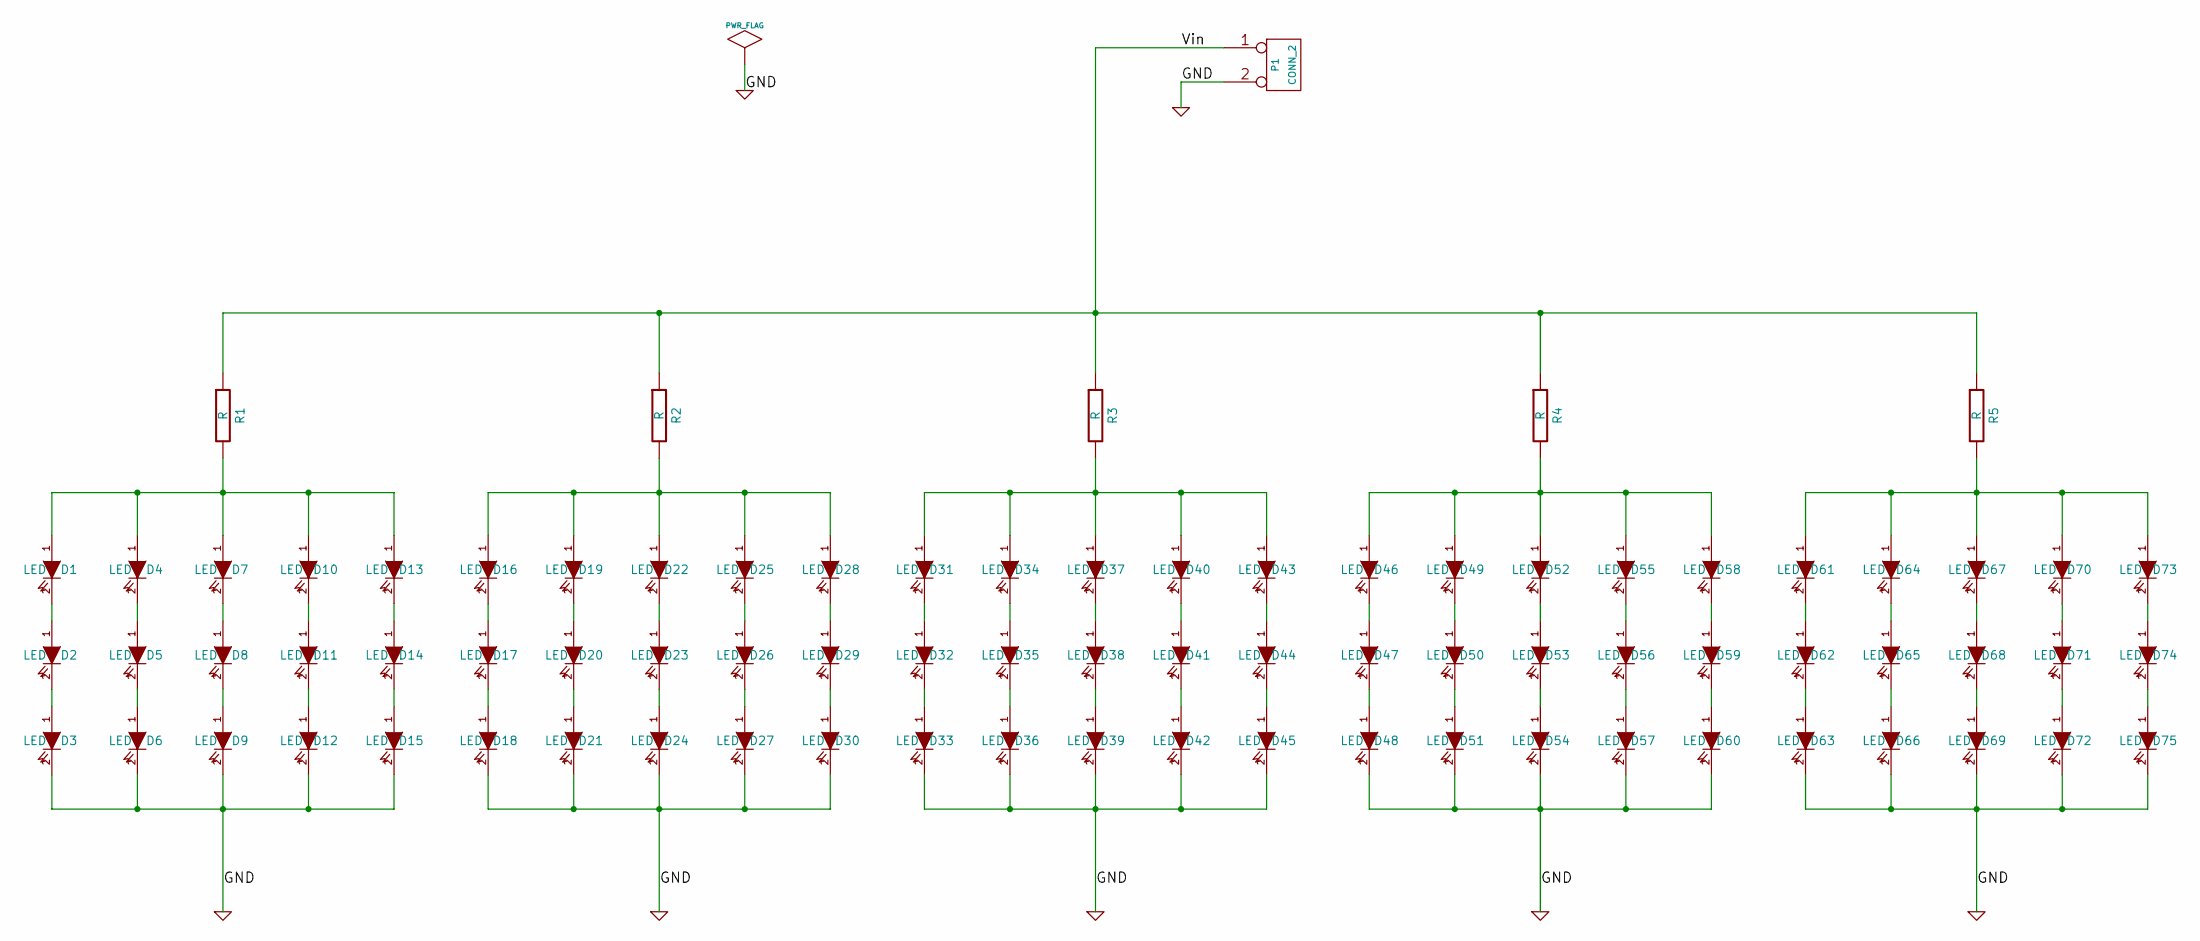
[picture p39: schematic expresso_led.sch]

Parts:
D1, D2, D3, D4, D5, D6, D7, D8, D9, D10, D11, D12, D13, D14, D15, D16, D17, D18, D19, D20, D21, D22, D23, D24, D25, D26, D27, D28, D29, D30, D31, D32, D33, D34, D35, D36, D37, D38, D39, D40, D41, D42, D43, D44, D45, D46, D47, D48, D49, D50, D51, D52, D53, D54, D55, D56, D57, D58, D59, D60, D61, D62, D63, D64, D65, D66, D67, D68, D69, D70, D71, D72, D73, D74, D75: LED
P1: CONN_2
R1, R2, R3, R4, R5: R

Connections:
GND: D3.2 (K), D6.2 (K), D9.2 (K), D12.2 (K), D15.2 (K), D18.2 (K), D21.2 (K), D24.2 (K), D27.2 (K), D30.2 (K), D33.2 (K), D36.2 (K), D39.2 (K), D42.2 (K), D45.2 (K), D48.2 (K), D51.2 (K), D54.2 (K), D57.2 (K), D60.2 (K), D63.2 (K), D66.2 (K), D69.2 (K), D72.2 (K), D75.2 (K), P1.2 (PM)
unnamed: D1.1 (A), D4.1 (A), D7.1 (A), D10.1 (A), D13.1 (A), R1.2
unnamed: D1.2 (K), D2.1 (A)
unnamed: D2.2 (K), D3.1 (A)
unnamed: D4.2 (K), D5.1 (A)
unnamed: D5.2 (K), D6.1 (A)
unnamed: D7.2 (K), D8.1 (A)
unnamed: D8.2 (K), D9.1 (A)
unnamed: D10.2 (K), D11.1 (A)
unnamed: D11.2 (K), D12.1 (A)
unnamed: D13.2 (K), D14.1 (A)
unnamed: D14.2 (K), D15.1 (A)
unnamed: D16.1 (A), D19.1 (A), D22.1 (A), D25.1 (A), D28.1 (A), R2.2
unnamed: D16.2 (K), D17.1 (A)
unnamed: D17.2 (K), D18.1 (A)
unnamed: D19.2 (K), D20.1 (A)
unnamed: D20.2 (K), D21.1 (A)
unnamed: D22.2 (K), D23.1 (A)
unnamed: D23.2 (K), D24.1 (A)
unnamed: D25.2 (K), D26.1 (A)
unnamed: D26.2 (K), D27.1 (A)
unnamed: D28.2 (K), D29.1 (A)
unnamed: D29.2 (K), D30.1 (A)
unnamed: D31.1 (A), D34.1 (A), D37.1 (A), D40.1 (A), D43.1 (A), R3.2
unnamed: D31.2 (K), D32.1 (A)
unnamed: D32.2 (K), D33.1 (A)
unnamed: D34.2 (K), D35.1 (A)
unnamed: D35.2 (K), D36.1 (A)
unnamed: D37.2 (K), D38.1 (A)
unnamed: D38.2 (K), D39.1 (A)
unnamed: D40.2 (K), D41.1 (A)
unnamed: D41.2 (K), D42.1 (A)
unnamed: D43.2 (K), D44.1 (A)
unnamed: D44.2 (K), D45.1 (A)
unnamed: D46.1 (A), D49.1 (A), D52.1 (A), D55.1 (A), D58.1 (A), R4.2
unnamed: D46.2 (K), D47.1 (A)
unnamed: D47.2 (K), D48.1 (A)
unnamed: D49.2 (K), D50.1 (A)
unnamed: D50.2 (K), D51.1 (A)
unnamed: D52.2 (K), D53.1 (A)
unnamed: D53.2 (K), D54.1 (A)
unnamed: D55.2 (K), D56.1 (A)
unnamed: D56.2 (K), D57.1 (A)
unnamed: D58.2 (K), D59.1 (A)
unnamed: D59.2 (K), D60.1 (A)
unnamed: D61.1 (A), D64.1 (A), D67.1 (A), D70.1 (A), D73.1 (A), R5.2
unnamed: D61.2 (K), D62.1 (A)
unnamed: D62.2 (K), D63.1 (A)
unnamed: D64.2 (K), D65.1 (A)
unnamed: D65.2 (K), D66.1 (A)
unnamed: D67.2 (K), D68.1 (A)
unnamed: D68.2 (K), D69.1 (A)
unnamed: D70.2 (K), D71.1 (A)
unnamed: D71.2 (K), D72.1 (A)
unnamed: D73.2 (K), D74.1 (A)
unnamed: D74.2 (K), D75.1 (A)
Vin: P1.1, R1.1, R2.1, R3.1, R4.1, R5.1
