iorodeo/expresso_device_hardware/pcb/sensor/expresso_sensor.sch

## KiCad design pcb/sensor/expresso_sensor.sch (2012-10-12)

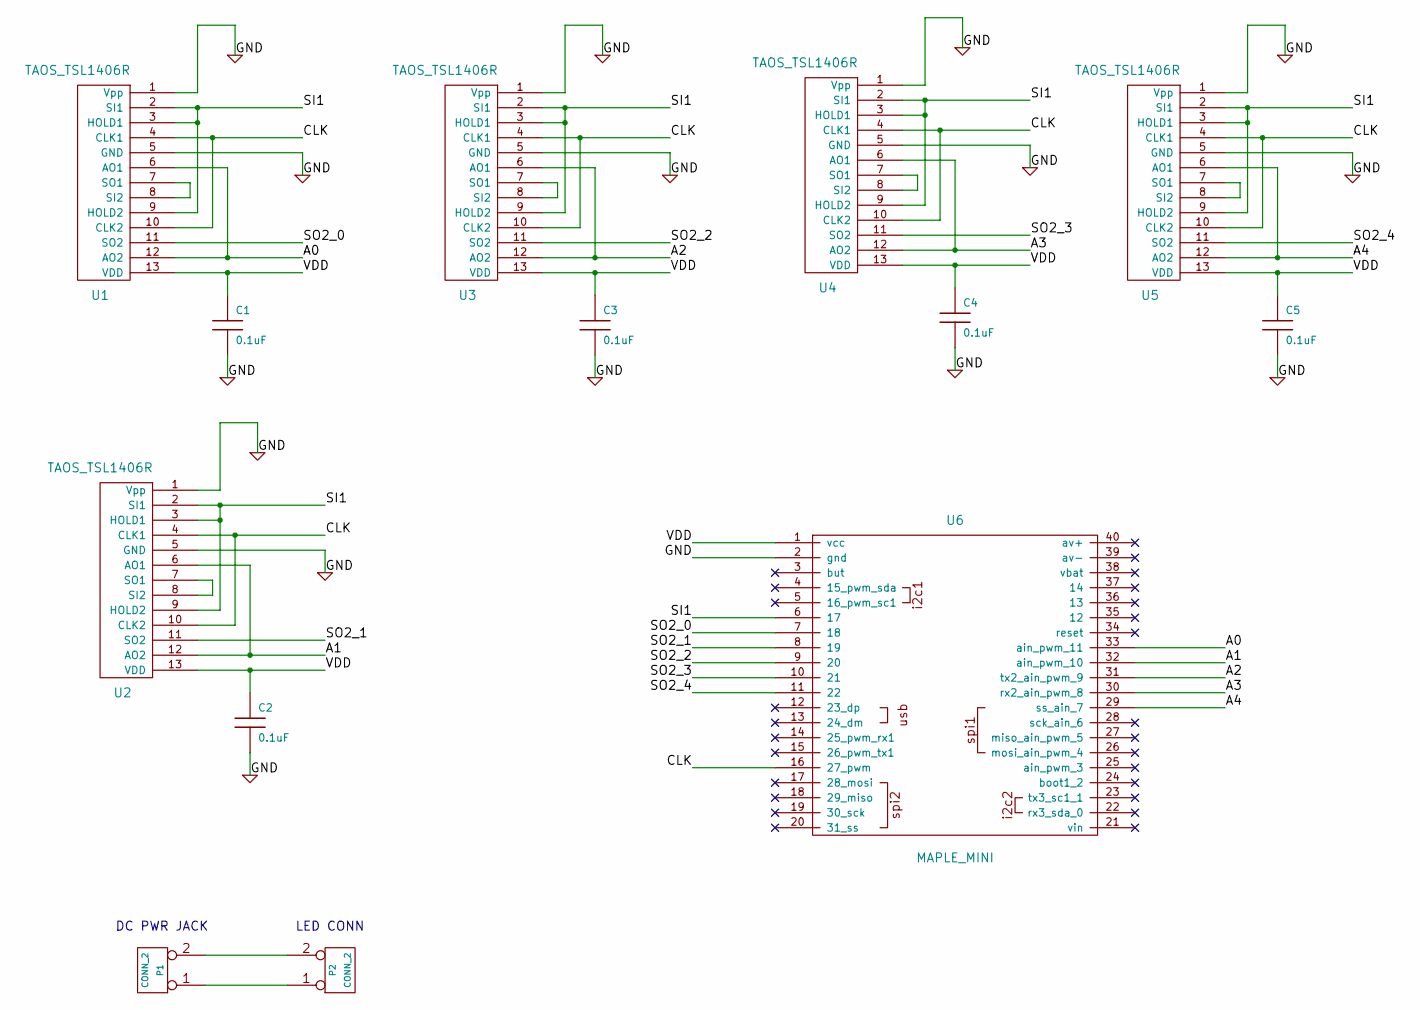
[picture p40: schematic expresso_sensor.sch]

Parts:
C1, C2, C3, C4, C5: 0.1uF
P1, P2: CONN_2
U1, U2, U3, U4, U5: TAOS_TSL1406R
U6: MAPLE_MINI

Connections:
A0: U1.6 (AO1), U1.12 (AO2), U6.33 (ain_pwm_11)
A1: U2.6 (AO1), U2.12 (AO2), U6.32 (ain_pwm_10)
A2: U3.6 (AO1), U3.12 (AO2), U6.31 (tx2_ain_pwm_9)
A3: U4.6 (AO1), U4.12 (AO2), U6.30 (rx2_ain_pwm_8)
A4: U5.6 (AO1), U5.12 (AO2), U6.29 (ss_ain_7)
CLK: U1.4 (CLK1), U1.10 (CLK2), U2.4 (CLK1), U2.10 (CLK2), U3.4 (CLK1), U3.10 (CLK2), U4.4 (CLK1), U4.10 (CLK2), U5.4 (CLK1), U5.10 (CLK2), U6.16 (27_pwm)
GND: C1.2, C2.2, C3.2, C4.2, C5.2, U1.1 (Vpp), U1.5 (GND), U2.1 (Vpp), U2.5 (GND), U3.1 (Vpp), U3.5 (GND), U4.1 (Vpp), U4.5 (GND), U5.1 (Vpp), U5.5 (GND), U6.2 (gnd)
unnamed: P1.1, P2.1
unnamed: P1.2 (PM), P2.2 (PM)
unnamed: U1.7 (SO1), U1.8 (SI2)
unnamed: U2.7 (SO1), U2.8 (SI2)
unnamed: U3.7 (SO1), U3.8 (SI2)
unnamed: U4.7 (SO1), U4.8 (SI2)
unnamed: U5.7 (SO1), U5.8 (SI2)
SI1: U1.2 (SI1), U1.3 (HOLD1), U1.9 (HOLD2), U2.2 (SI1), U2.3 (HOLD1), U2.9 (HOLD2), U3.2 (SI1), U3.3 (HOLD1), U3.9 (HOLD2), U4.2 (SI1), U4.3 (HOLD1), U4.9 (HOLD2), U5.2 (SI1), U5.3 (HOLD1), U5.9 (HOLD2), U6.6 (17)
SO2_0: U1.11 (SO2), U6.7 (18)
SO2_1: U2.11 (SO2), U6.8 (19)
SO2_2: U3.11 (SO2), U6.9 (20)
SO2_3: U4.11 (SO2), U6.10 (21)
SO2_4: U5.11 (SO2), U6.11 (22)
VDD: C1.1, C2.1, C3.1, C4.1, C5.1, U1.13 (VDD), U2.13 (VDD), U3.13 (VDD), U4.13 (VDD), U5.13 (VDD), U6.1 (vcc)

Notes on the sheet:
LED CONN
DC PWR JACK
