iorodeo/expresso_device_hardware/(commit log)

2012-07-24 consolidated enclosure and rack files into one repository.
2012-07-24 added pcb design files.
    [$savepcb.brd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]
2012-07-24 changed the location of mount holes to 5-inch spacing.
    [expresso_led.brd]
2012-09-21 Major refactoring of the code for the enclosure. Finished layout of the PCBs
    [$savepcb.brd, expresso_led.brd, expresso_led.dsn, expresso_sensor.brd, expresso_sensor.dsn, expresso_sensor.sch]
2012-09-25 generated gerbers and finalized BOM
    [expresso_led.brd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]
2012-09-26 organizing rack files. adding dxf files to repo.
    [back.dxf, bottom.dxf, diffuser.dxf, front.dxf, guide_side_neg_A.dxf, guide_side_pos_A.dxf, guide_top.dxf, left_wall.dxf]
2012-09-27 added new cutting job, fixed hole sizes for plungers
    [back.dxf, back.scad, back_2.dxf, bottom.dxf, bottom.scad, bottom_2.dxf, diffuser.scad, diffuser_2.dxf]
2012-09-27 started working on the enclosure top
    [back_2.dxf, bottom_2.dxf, front.dxf, front.scad, front_2.dxf, left_wall.dxf, left_wall.scad, plunger_strip_2.dxf]
2012-10-02 Modifying rack to allow producing 1x5- to nx5-channel version.
    [back.scad, enclosure_assembly.scad, enclosure_projection.scad, front.scad, left_wall.scad, rack_assembly.scad, right_wall.scad, top.scad]
2012-10-03 working on reconfigurable rack.
    [rack_assembly.scad]
2012-10-05 new laser cutting file.
2012-10-12 Redesigned sensor pcb, and modified enclosure accordingly.
    [back.dxf, back.scad, bottom.dxf, bottom.scad, diffuser.dxf, diffuser.scad, enclosure_assembly.scad, enclosure_projection.scad]
2012-10-12 switched design files to pdf
2012-10-12 regenerated individual scad files
    [bottom.dxf, bottom.scad, enclosure_assembly.scad, enclosure_projection.scad, expresso_sensor.brd, plunger_strip.dxf, plunger_strip.scad]
2012-10-15 regenerated dxf
    [bottom.dxf, bottom.scad, enclosure_assembly.scad, enclosure_projection.scad, rack_assembly.scad]
2012-10-16 added new cutting job
    [back_2.dxf, bottom_2.dxf, diffuser_2.dxf, front_2.dxf, guide_side_neg_A_2.dxf, guide_side_pos_A_2.dxf, guide_top_2.dxf, plunger_strip_2.dxf]
2012-10-17 corrected push button holes on pdf.
2012-10-18 changed top tab size
    [back.dxf, back.scad, bottom.dxf, bottom.scad, diffuser.dxf, diffuser.scad, enclosure_assembly.scad, enclosure_projection.scad]
2012-10-18 added longer tabs to negative side
    [back.dxf, back.scad, enclosure_assembly.scad, enclosure_projection.scad, front.dxf, front.scad]
2012-10-19 added asymmetric tabs.
    [back.dxf, back.scad, back_2.dxf, bottom.dxf, bottom_2.dxf, diffuser.dxf, diffuser_2.dxf, enclosure_assembly.scad]
2012-10-19 added missing dxf files
    [bottom.dxf, diffuser.dxf, guide_side_neg_A.dxf, guide_side_pos_A.dxf, guide_top.dxf, plunger_strip.dxf, ref_cube.dxf, top.dxf]
2012-10-20 included changed tabs into pdf for laser-cutting
    [back2.dxf, front2.dxf, left_wall2.dxf, right_wall2.dxf]
2012-10-30 changed cutout sizes for maple
    [bottom.dxf, bottom.scad, enclosure_assembly.scad, enclosure_projection.scad]
2013-01-22 changed top lip and asymmetry
    [$savepcb.brd, back.dxf, back.scad, bottom.dxf, bottom.scad, enclosure_assembly.scad, enclosure_projection.scad, expresso_led.brd]
2013-01-23 changes for a 3mm black + 1.5mm clear top. Also changed lip sizes. pdf files updated
    [back2.dxf, front2.dxf]
2013-03-13 rack's shelf is now 3mm thick
    [expresso_led-Back.gbl, expresso_led-Front.gtl, expresso_led-Mask_Back.gbs, expresso_led-Mask_Front.gts, expresso_led-PCB_Edges.gbr, expresso_led-SilkS_Back.gbo, expresso_led-SilkS_Front.gto, expresso_led.drl]
2013-03-14 Fixed slot size problem on the floor.
    [floor.dxf, floor.scad, left_holder.dxf, left_holder.scad, left_wall.dxf, left_wall.scad, rack_assembly.scad, right_holder.dxf]
2013-05-09 Added flyholder design.
    [assembly.fcstd, assembly_exploded.fcstd, base.fcstd, base.step, cuvette_block.fcstd, cuvette_block.step, door.fcstd, door.step]
2013-05-25 Modified fly holder design. created step and laser cutting files.
    [assembly.fcstd, assembly_exploded.fcstd, base.fcstd, base.step, cuvette_block.fcstd, cuvette_block.step, door.step, feeder_block.fcstd]
2013-06-08 Fixed issue with top mount hole positons.
    [feeder_block.fcstd, top.fcstd]
2016-09-18 Remade gerber files.
    [expresso_led-B_Mask.gbs, expresso_led-B_SilkS.gbo, expresso_led-Back.gbl, expresso_led-Edge_Cuts.gbr, expresso_led-F_Mask.gts, expresso_led-F_SilkS.gto, expresso_led-Front.gtl, expresso_led-Mask_Back.gbs]
2016-09-18 Added drill file.
    [expresso_led.drl]
